NuttyShell/NuttyBadge/README.md

# NuttyBadge
NuttyBadge: A NuttyShell crafted security and hardware multi-tool. Open-sourced Hardware and Software.

## Hardware
[Click here for Hardware](NuttyHardware): Full Schematic and PCBs, along with BOM list

## Software
[Click here for Software](NuttyOS): Full Software based on ESP-IDF and FreeRTOS
