NuttyShell/NuttyBadge/NuttyHardware/Drill.png

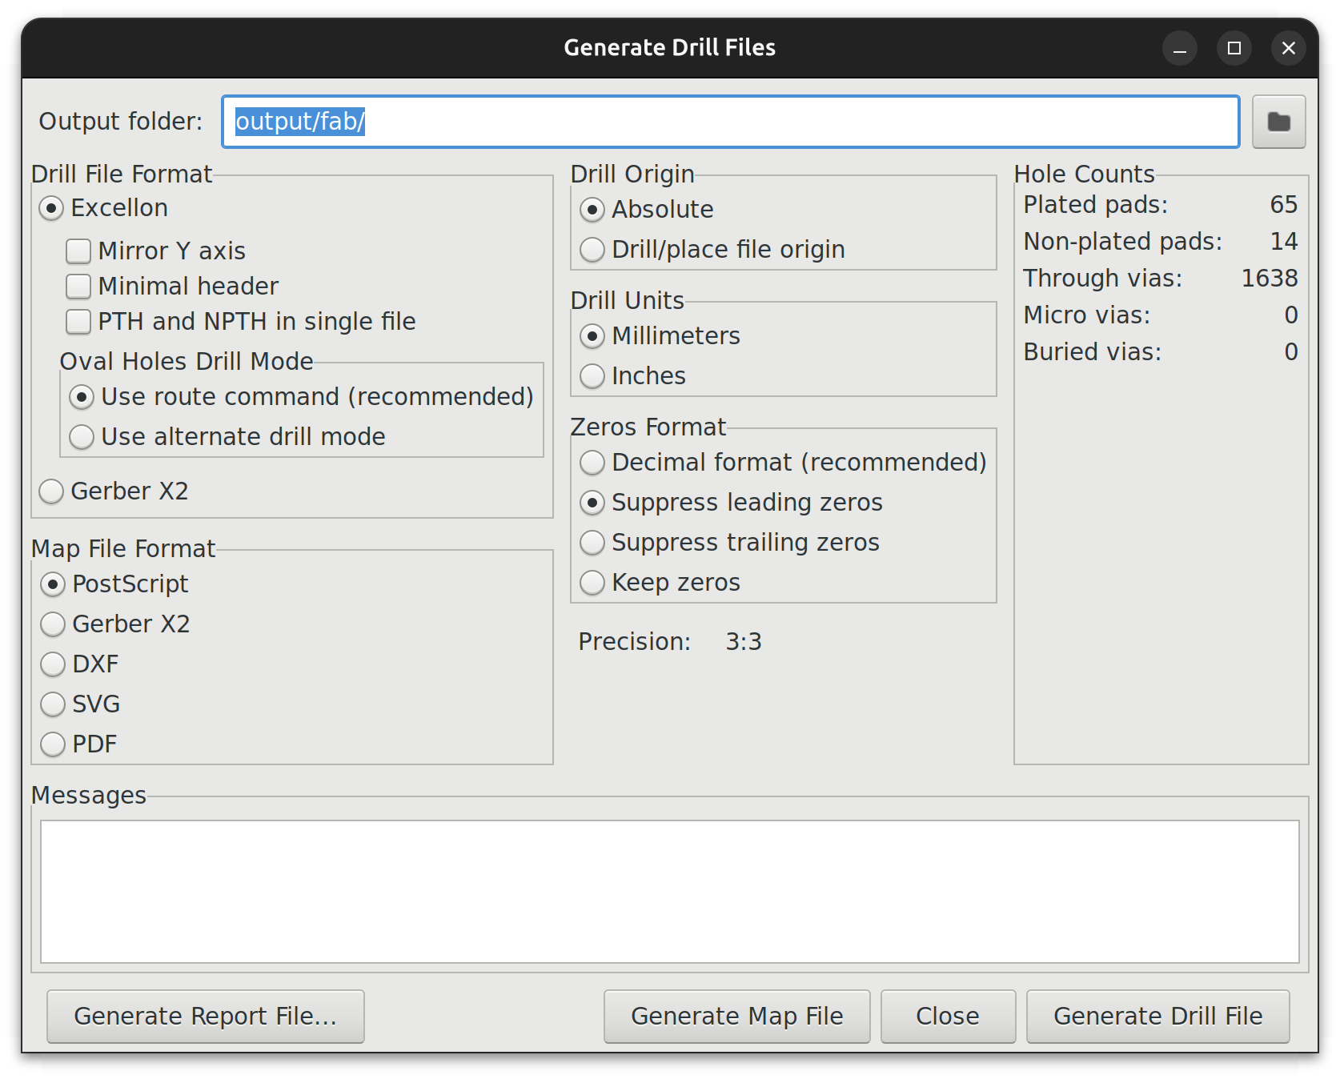
NuttyHardware/Drill.png
