NuttyShell/NuttyBadge/NuttyHardware/Gerber.png

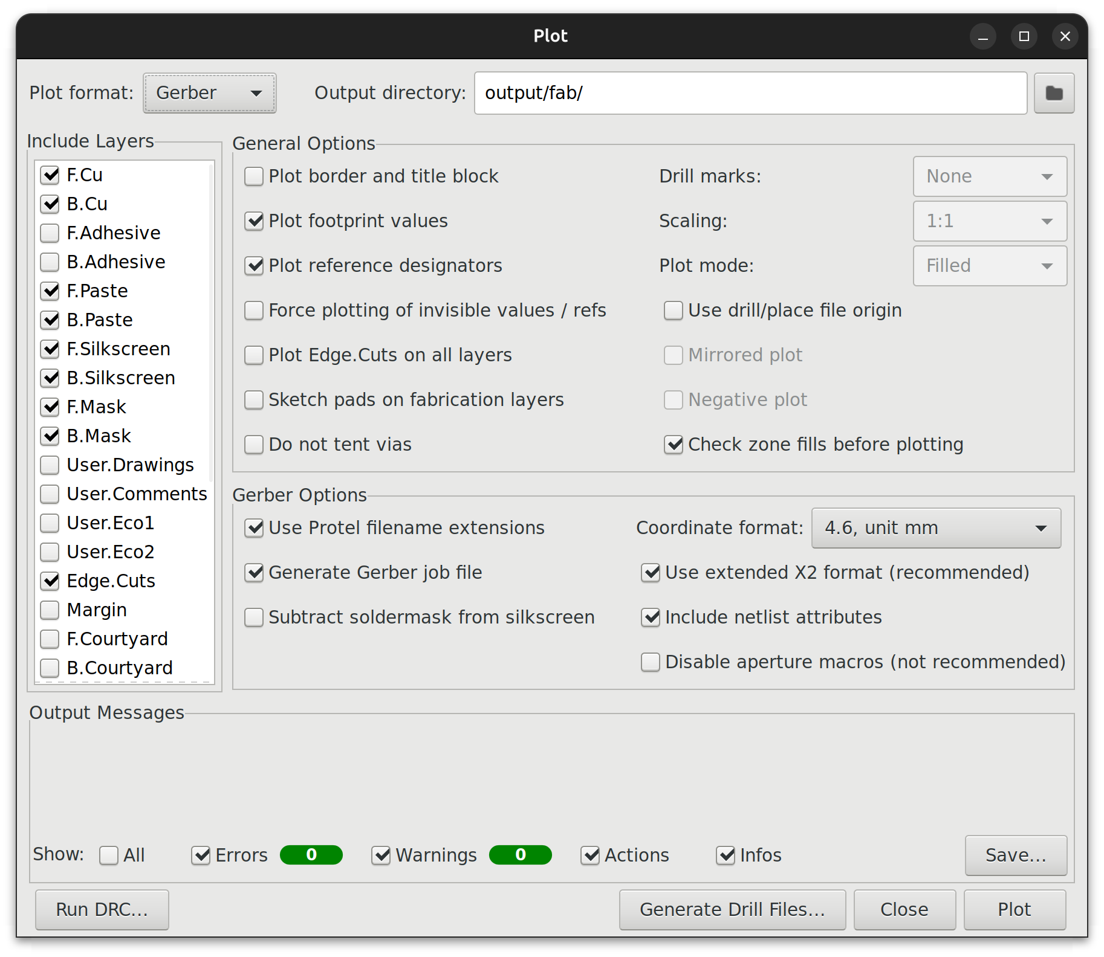
NuttyHardware/Gerber.png
