NuttyShell/NuttyBadge/NuttyHardware/vendor_modules/esp32-s3-luatos/esp32s3.F.png

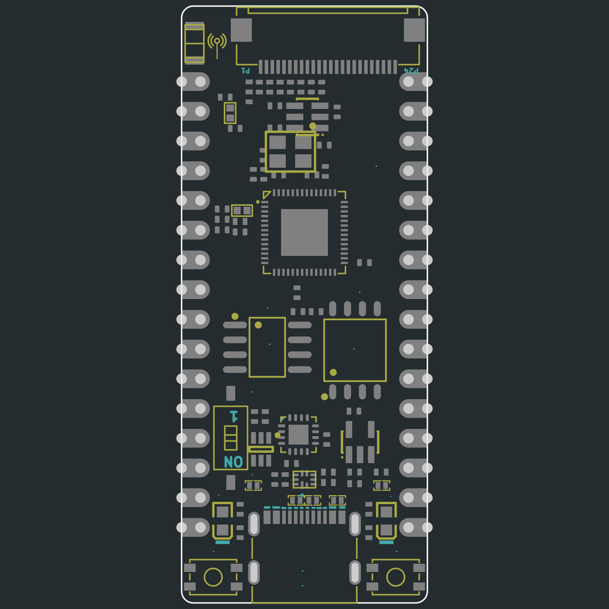
NuttyHardware/vendor_modules/esp32-s3-luatos/esp32s3.F.png
