NuttyShell/NuttyBadge/NuttyHardware/ViaStitching-KiCAD7-Settings.png

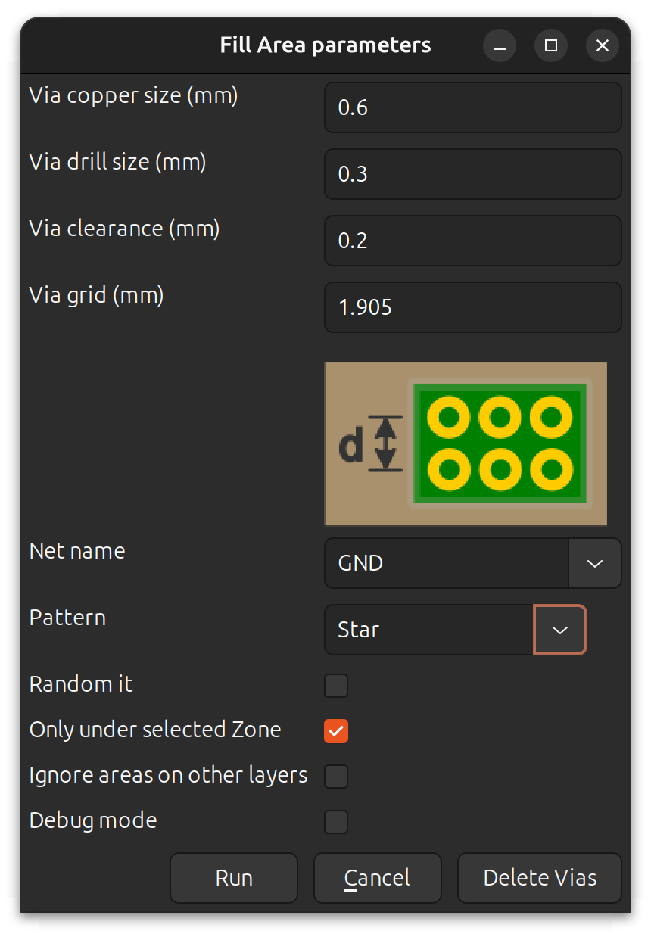
NuttyHardware/ViaStitching-KiCAD7-Settings.png
