NuttyShell/NuttyBadge/NuttyHardware/mass_production_revc/BOM_PCBA.xlsx

Reference(s) | 值 | LibPart | Footprint | 描述 | 封装 | 淘宝参考链接 | 类型
BT1 | AA_Battery | Device:Battery | Custom:BatteryHolder_2AA | 2节5号电池盒 | 直插电池盒 | https://item.taobao.com/item.htm?id=607322824447 | 直插
BZ1 | 8530_SMDPassiveBuzzer | Device:Buzzer | Buzzer_Beeper:MagneticBuzzer_Kobitone_254-EMB84Q-RO | MLT-8530 [3V] 电磁式贴片蜂鸣器 | 8530 | https://item.taobao.com/item.htm?id=555924156309 | 贴片
C1 | 100n | Device:C_Small | Capacitor_SMD:C_1206_3216Metric_Pad1.33x1.80mm_HandSolder | 104 ±10% 贴片电容 | 1206 | https://item.taobao.com/item.htm?id=635534146001 | 贴片
C2 | 100n | Device:C_Small | Capacitor_SMD:C_1206_3216Metric_Pad1.33x1.80mm_HandSolder | 104 ±10% 贴片电容 | 1206 | https://item.taobao.com/item.htm?id=635534146001 | 贴片
C3 | 100n | Device:C | Capacitor_SMD:C_1206_3216Metric_Pad1.33x1.80mm_HandSolder | 104 ±10% 贴片电容 | 1206 | https://item.taobao.com/item.htm?id=635534146001 | 贴片
C4 | 100n | Device:C | Capacitor_SMD:C_1206_3216Metric_Pad1.33x1.80mm_HandSolder | 104 ±10% 贴片电容 | 1206 | https://item.taobao.com/item.htm?id=635534146001 | 贴片
C5 | 100n | Device:C_Small | Capacitor_SMD:C_1206_3216Metric_Pad1.33x1.80mm_HandSolder | 104 ±10% 贴片电容 | 1206 | https://item.taobao.com/item.htm?id=635534146001 | 贴片
C6 | 100n | Device:C_Small | Capacitor_SMD:C_1206_3216Metric_Pad1.33x1.80mm_HandSolder | 104 ±10% 贴片电容 | 1206 | https://item.taobao.com/item.htm?id=635534146001 | 贴片
C7 | 100n | Device:C_Small | Capacitor_SMD:C_1206_3216Metric_Pad1.33x1.80mm_HandSolder | 104 ±10% 贴片电容 | 1206 | https://item.taobao.com/item.htm?id=635534146001 | 贴片
C8 | 10u | Device:C | Capacitor_SMD:C_1206_3216Metric_Pad1.33x1.80mm_HandSolder | 106 ±10% X5R 贴片电容 | 1206 | https://item.taobao.com/item.htm?id=537772527714 | 贴片
C9 | 100n | Device:C | Capacitor_SMD:C_1206_3216Metric_Pad1.33x1.80mm_HandSolder | 104 ±10% 贴片电容 | 1206 | https://item.taobao.com/item.htm?id=635534146001 | 贴片
C10 | 100n | Device:C | Capacitor_SMD:C_1206_3216Metric_Pad1.33x1.80mm_HandSolder | 104 ±10% 贴片电容 | 1206 | https://item.taobao.com/item.htm?id=635534146001 | 贴片
C11 | 100n | Device:C | Capacitor_SMD:C_1206_3216Metric_Pad1.33x1.80mm_HandSolder | 104 ±10% 贴片电容 | 1206 | https://item.taobao.com/item.htm?id=635534146001 | 贴片
C12 | 100n | Device:C | Capacitor_SMD:C_1206_3216Metric_Pad1.33x1.80mm_HandSolder | 104 ±10% 贴片电容 | 1206 | https://item.taobao.com/item.htm?id=635534146001 | 贴片
C13 | 10u | Device:C | Capacitor_SMD:C_1206_3216Metric_Pad1.33x1.80mm_HandSolder | 106 ±10% X5R 贴片电容 | 1206 | https://item.taobao.com/item.htm?id=537772527714 | 贴片
C14 | 100n | Device:C | Capacitor_SMD:C_1206_3216Metric_Pad1.33x1.80mm_HandSolder | 104 ±10% 贴片电容 | 1206 | https://item.taobao.com/item.htm?id=635534146001 | 贴片
C15 | 100n | Device:C_Small | Capacitor_SMD:C_1206_3216Metric_Pad1.33x1.80mm_HandSolder | 104 ±10% 贴片电容 | 1206 | https://item.taobao.com/item.htm?id=635534146001 | 贴片
C16 | 10u | Device:C_Small | Capacitor_SMD:C_1206_3216Metric_Pad1.33x1.80mm_HandSolder | 106 ±10% X5R 贴片电容 | 1206 | https://item.taobao.com/item.htm?id=537772527714 | 贴片
C17 | 100n | Device:C | Capacitor_SMD:C_1206_3216Metric_Pad1.33x1.80mm_HandSolder | 104 ±10% 贴片电容 | 1206 | https://item.taobao.com/item.htm?id=635534146001 | 贴片
C18 | 10u | Device:C_Small | Capacitor_SMD:C_1206_3216Metric_Pad1.33x1.80mm_HandSolder | 106 ±10% X5R 贴片电容 | 1206 | https://item.taobao.com/item.htm?id=537772527714 | 贴片
C19 | 100n | Device:C_Small | Capacitor_SMD:C_1206_3216Metric_Pad1.33x1.80mm_HandSolder | 104 ±10% 贴片电容 | 1206 | https://item.taobao.com/item.htm?id=635534146001 | 贴片
C20 | 1u | Device:C_Small | Capacitor_SMD:C_1206_3216Metric_Pad1.33x1.80mm_HandSolder | 105 ±10% X7R 贴片电容 | 1206 | https://item.taobao.com/item.htm?id=561250887432 | 贴片
C21 | 100n | Device:C_Small | Capacitor_SMD:C_1206_3216Metric_Pad1.33x1.80mm_HandSolder | 104 ±10% 贴片电容 | 1206 | https://item.taobao.com/item.htm?id=635534146001 | 贴片
C22 | 10u | Device:C | Capacitor_SMD:C_1206_3216Metric_Pad1.33x1.80mm_HandSolder | 106 ±10% X5R 贴片电容 | 1206 | https://item.taobao.com/item.htm?id=537772527714 | 贴片
C23 | 1u | Device:C_Small | Capacitor_SMD:C_1206_3216Metric_Pad1.33x1.80mm_HandSolder | 105 ±10% X7R 贴片电容 | 1206 | https://item.taobao.com/item.htm?id=561250887432 | 贴片
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
C50 | 100n | Device:C | Capacitor_SMD:C_1206_3216Metric_Pad1.33x1.80mm_HandSolder | 104 ±10% 贴片电容 | 1206 | https://item.taobao.com/item.htm?id=635534146001 | 贴片
C51 | NC | Device:C | Capacitor_SMD:C_1206_3216Metric_Pad1.33x1.80mm_HandSolder | 不用焊接 | 不用焊接 | 不用焊接 | 不用焊接
C52 | 10u | Device:C | Capacitor_SMD:C_1206_3216Metric_Pad1.33x1.80mm_HandSolder | 106 ±10% X5R 贴片电容 | 1206 | https://item.taobao.com/item.htm?id=537772527714 | 贴片
D1 | 1N4148W | Diode:1N4148W | Custom:D_SOD-123-BigDiodeSilkscreen | 贴片开关二极管 | SOD-123 | https://item.taobao.com/item.htm?id=660511928550 | 贴片
D2 | 1N4148W | Diode:1N4148W | Custom:D_SOD-123-BigDiodeSilkscreen | 贴片开关二极管 | SOD-123 | https://item.taobao.com/item.htm?id=660511928550 | 贴片
D3 | 1N4148W | Diode:1N4148W | Custom:D_SOD-123-BigDiodeSilkscreen | 贴片开关二极管 | SOD-123 | https://item.taobao.com/item.htm?id=660511928550 | 贴片
D4 | 1N4148W | Diode:1N4148W | Custom:D_SOD-123-BigDiodeSilkscreen | 贴片开关二极管 | SOD-123 | https://item.taobao.com/item.htm?id=660511928550 | 贴片
D5 | 1N4148W | Diode:1N4148W | Custom:D_SOD-123-BigDiodeSilkscreen | 贴片开关二极管 | SOD-123 | https://item.taobao.com/item.htm?id=660511928550 | 贴片
D6 | 1N4148W | Diode:1N4148W | Custom:D_SOD-123-BigDiodeSilkscreen | 贴片开关二极管 | SOD-123 | https://item.taobao.com/item.htm?id=660511928550 | 贴片
D7 | 1N4148W | Diode:1N4148W | Custom:D_SOD-123-BigDiodeSilkscreen | 贴片开关二极管 | SOD-123 | https://item.taobao.com/item.htm?id=660511928550 | 贴片
D8 | 1N4148W | Diode:1N4148W | Custom:D_SOD-123-BigDiodeSilkscreen | 贴片开关二极管 | SOD-123 | https://item.taobao.com/item.htm?id=660511928550 | 贴片
D9 | 1N4148W | Diode:1N4148W | Custom:D_SOD-123-BigDiodeSilkscreen | 贴片开关二极管 | SOD-123 | https://item.taobao.com/item.htm?id=660511928550 | 贴片
D10 | WS2812B | LED:WS2812B | Custom:LED_WS2812B_PLCC4_5.0x5.0mm_P3.2mm-TriangleSilkscreen | RGB发光二极管 | 5050 | https://item.taobao.com/item.htm?id=686018450822 | 贴片
D11 | WS2812B | LED:WS2812B | Custom:LED_WS2812B_PLCC4_5.0x5.0mm_P3.2mm-TriangleSilkscreen | RGB发光二极管 | 5050 | https://item.taobao.com/item.htm?id=686018450822 | 贴片
D12 | PMEG2005EGW | Diode:1N4148W | Custom:D_SOD-123-BigDiodeSilkscreen | 低VF MEGA肖特基势垒整流器 | SOD-123 | https://item.taobao.com/item.htm?id=586340327081 | 贴片
D13 | 940nmIR_5mmLED | Device:LED | LED_THT:LED_D5.0mm_Horizontal_O3.81mm_Z3.0mm | 940nm红外发射二极管 | 5mm 直插 | https://item.taobao.com/item.htm?id=522572650100 | 直插
D14 | 940nmIR_5mmLED | Device:LED | LED_THT:LED_D5.0mm_Horizontal_O3.81mm_Z3.0mm | 940nm红外发射二极管 | 5mm 直插 | https://item.taobao.com/item.htm?id=522572650100 | 直插
D15 | WS2812B | LED:WS2812B | Custom:LED_WS2812B_PLCC4_5.0x5.0mm_P3.2mm-TriangleSilkscreen | RGB发光二极管 | 5050 | https://item.taobao.com/item.htm?id=686018450822 | 贴片
D16 | 1N4148W | Diode:1N4148W | Custom:D_SOD-123-BigDiodeSilkscreen | 贴片开关二极管 | SOD-123 | https://item.taobao.com/item.htm?id=660511928550 | 贴片
D17 | PMEG2005EGW | Diode:1N4148W | Custom:D_SOD-123-BigDiodeSilkscreen | 低VF MEGA肖特基势垒整流器 | SOD-123 | https://item.taobao.com/item.htm?id=586340327081 | 贴片
D18 | SS34 | Diode:1N5822 | Custom:D_SMA_Handsoldering-BigDiodeSilkscreen | 肖特基二极管 | SMA (DO-214AC) | https://item.taobao.com/item.htm?id=545422120963 | 贴片
D19 | BLUE LED | Device:LED_Filled | Custom:LED_0805_2012Metric_Pad1.15x1.40mm_HandSolder-BigDiodeSilkscreen | 蓝色LED灯珠/发光二极管 | 0805 | https://item.taobao.com/item.htm?id=570459797098 | 贴片
FB1 | CBW321609U121T | Device:FerriteBead_Small | Inductor_SMD:L_1206_3216Metric_Pad1.42x1.75mm_HandSolder | 3A, 120R@100MHz, Rdc<0.1R 贴片磁珠 | 1206 | https://item.taobao.com/item.htm?id=655861159778 | 贴片
H1 | MountingHole | Mechanical:MountingHole | MountingHole:MountingHole_3.2mm_M3_ISO7380 | 固定孔，请忽略 | 固定孔，请忽略 | 固定孔，请忽略 | 固定孔，请忽略
H2 | MountingHole | Mechanical:MountingHole | MountingHole:MountingHole_3.2mm_M3_ISO7380 | 固定孔，请忽略 | 固定孔，请忽略 | 固定孔，请忽略 | 固定孔，请忽略
H3 | MountingHole | Mechanical:MountingHole | MountingHole:MountingHole_3.2mm_M3_ISO7380 | 固定孔，请忽略 | 固定孔，请忽略 | 固定孔，请忽略 | 固定孔，请忽略
H4 | MountingHole | Mechanical:MountingHole | MountingHole:MountingHole_3.2mm_M3_ISO7380 | 固定孔，请忽略 | 固定孔，请忽略 | 固定孔，请忽略 | 固定孔，请忽略
J1 | RGB_OUT | Connector:Conn_01x03_Male | Connector_PinHeader_2.54mm:PinHeader_1x03_P2.54mm_Vertical | 不用焊接 | 不用焊接 | 不用焊接 | 不用焊接
J2 | CC_MODULE | Connector_Generic:Conn_02x04_Odd_Even | Custom:PinSocket_2x04_P2.54mm_Vertical_PinNumberFlipped | 不用焊接 | 不用焊接 | 不用焊接 | 不用焊接
J3 | Micro_SD_Card_Det | MicroSD_Slot:Micro_SD_Card_Det | Custom:Conn_uSDcard | 贴片TF卡卡座 外焊-自弹-镀金 | 见淘宝链接 | https://item.taobao.com/item.htm?id=720212395210 | 贴片
J4 | Expose_GPIOs | Connector:Conn_01x07_Female | Connector_PinHeader_2.54mm:PinHeader_1x07_P2.54mm_Vertical | 不用焊接 | 不用焊接 | 不用焊接 | 不用焊接
J5 | I2C_Pins | Connector:Conn_01x04_Female | Connector_PinSocket_2.54mm:PinSocket_1x04_P2.54mm_Vertical | 不用焊接 | 不用焊接 | 不用焊接 | 不用焊接
J6 | Power_Pins | Connector_Generic:Conn_02x04_Odd_Even | Custom:PinSocket_2x04_P2.54mm_Vertical_PinNumberFlipped | 不用焊接 | 不用焊接 | 不用焊接 | 不用焊接
J7 | Expose_SDPins | Connector:Conn_01x05_Female | Connector_PinHeader_2.54mm:PinHeader_1x05_P2.54mm_Vertical | 不用焊接 | 不用焊接 | 不用焊接 | 不用焊接
J8 | FPC0.5-24P | Connector_Generic:Conn_01x24 | Connector_FFC-FPC:Jushuo_AFC07-S24FCA-00_1x24-1MP_P0.50_Horizontal | 24P 0.5mm FPC 翻盖 下接 连接器 | FPC 0.5mm | https://item.taobao.com/item.htm?id=552629356951 | 贴片
J9 | USB Type-C Port | Connector:USB_C_Receptacle_USB2.0 | Connector_USB:USB_C_Receptacle_HRO_TYPE-C-31-M-12 | USB Type-C 16P母座(板上四脚插)-蓝色 | 蓝色 Type-C USB 母座 | https://item.taobao.com/item.htm?id=737614485085 | 贴片
L1 | 3.3uH | Device:L | Inductor_SMD:L_Wuerth_HCI-1040 | 3.3uH 贴片功率电感 | 1040 | https://item.taobao.com/item.htm?id=624687278924 | 贴片
Q1 | MMBT3904 | Transistor_BJT:MMBT3904 | Q1 | NPN晶体管 | SOT-23 | https://item.taobao.com/item.htm?id=578927102886 | 贴片
Q2 | NC | Transistor_FET:AO3400A | Q2 | 不用焊接 | 不用焊接 | 不用焊接 | 不用焊接
Q3 | IRF9321PbF | Transistor_FET:IRF7404 | Q3 | P沟道 MOSFET管 | SOIC-8 | https://item.taobao.com/item.htm?id=582370943063 | 贴片
Q4 | AO3400A | Transistor_FET:AO3400A | Q4 | N沟道 MOSFET管 | SOT-23 | https://item.taobao.com/item.htm?id=619513547316 | 贴片
Q5 | MMBT3904 | Transistor_BJT:MMBT3904 | Q5 | NPN晶体管 | SOT-23 | https://item.taobao.com/item.htm?id=578927102886 | 贴片
Q6 | MMBT3904 | Transistor_BJT:MMBT3904 | Q6 | NPN晶体管 | SOT-23 | https://item.taobao.com/item.htm?id=578927102886 | 贴片
Q7 | MMBT3904 | Transistor_BJT:MMBT3904 | Q7 | NPN晶体管 | SOT-23 | https://item.taobao.com/item.htm?id=578927102886 | 贴片
Q8 | MMBT3904 | Transistor_BJT:MMBT3904 | Q8 | NPN晶体管 | SOT-23 | https://item.taobao.com/item.htm?id=578927102886 | 贴片
Q9 | FDC6333C | Transistor_FET:DMC2053UVT | Q9 | N+P沟道 MOSFET管 | SOT-23-6 | https://item.taobao.com/item.htm?id=678270445729 | 贴片
Q10 | AO3401A | Transistor_FET:AO3401A | Q10 | P沟道 MOSFET管 | SOT-23 | https://item.taobao.com/item.htm?id=619514059506 | 贴片
Q11 | AO3400A | Transistor_FET:AO3400A | Q11 | N沟道 MOSFET管 | SOT-23 | https://item.taobao.com/item.htm?id=619513547316 | 贴片
Q12 | AO3401A | Transistor_FET:AO3401A | Q12 | P沟道 MOSFET管 | SOT-23 | https://item.taobao.com/item.htm?id=619514059506 | 贴片
R1 | 10K | Device:R | Resistor_SMD:R_1206_3216Metric_Pad1.30x1.75mm_HandSolder | 1002 贴片电阻 精度±1% | 1206 | https://item.taobao.com/item.htm?id=526184346746 | 贴片
R2 | 10K | Device:R | Resistor_SMD:R_1206_3216Metric_Pad1.30x1.75mm_HandSolder | 1002 贴片电阻 精度±1% | 1206 | https://item.taobao.com/item.htm?id=526184346746 | 贴片
R3 | 10K | Device:R | Resistor_SMD:R_1206_3216Metric_Pad1.30x1.75mm_HandSolder | 1002 贴片电阻 精度±1% | 1206 | https://item.taobao.com/item.htm?id=526184346746 | 贴片
R4 | 10K | Device:R | Resistor_SMD:R_1206_3216Metric_Pad1.30x1.75mm_HandSolder | 1002 贴片电阻 精度±1% | 1206 | https://item.taobao.com/item.htm?id=526184346746 | 贴片
R5 | 10K | Device:R | Resistor_SMD:R_1206_3216Metric_Pad1.30x1.75mm_HandSolder | 1002 贴片电阻 精度±1% | 1206 | https://item.taobao.com/item.htm?id=526184346746 | 贴片
R6 | 2K2 | Device:R | Resistor_SMD:R_1206_3216Metric_Pad1.30x1.75mm_HandSolder | 2201 贴片电阻 精度±1% | 1206 | https://item.taobao.com/item.htm?id=526184346746 | 贴片
R7 | 10K | Device:R | Resistor_SMD:R_1206_3216Metric_Pad1.30x1.75mm_HandSolder | 1002 贴片电阻 精度±1% | 1206 | https://item.taobao.com/item.htm?id=526184346746 | 贴片
R8 | 2K2 | Device:R | Resistor_SMD:R_1206_3216Metric_Pad1.30x1.75mm_HandSolder | 2201 贴片电阻 精度±1% | 1206 | https://item.taobao.com/item.htm?id=526184346746 | 贴片
R9 | 10R | Device:R | Resistor_SMD:R_1206_3216Metric_Pad1.30x1.75mm_HandSolder | 10R0 贴片电阻 精度±1% | 1206 | https://item.taobao.com/item.htm?id=526170748623 | 贴片
R10 | 10K | Device:R | Resistor_SMD:R_1206_3216Metric_Pad1.30x1.75mm_HandSolder | 1002 贴片电阻 精度±1% | 1206 | https://item.taobao.com/item.htm?id=526184346746 | 贴片
R11 | NC | Device:R | Resistor_SMD:R_1206_3216Metric_Pad1.30x1.75mm_HandSolder | 不用焊接 | 不用焊接 | 不用焊接 | 不用焊接
R12 | 3K | Device:R | Resistor_SMD:R_1206_3216Metric_Pad1.30x1.75mm_HandSolder | 3001 贴片电阻 精度±1% | 1206 | https://item.taobao.com/item.htm?id=526175737633 | 贴片
R13 | 1K | Device:R | Resistor_SMD:R_1206_3216Metric_Pad1.30x1.75mm_HandSolder | 1001 贴片电阻 精度±1% | 1206 | https://item.taobao.com/item.htm?id=526176009170 | 贴片
R14 | 10K | Device:R | Resistor_SMD:R_1206_3216Metric_Pad1.30x1.75mm_HandSolder | 1002 贴片电阻 精度±1% | 1206 | https://item.taobao.com/item.htm?id=526184346746 | 贴片
R15 | 10K | Device:R | Resistor_SMD:R_1206_3216Metric_Pad1.30x1.75mm_HandSolder | 1002 贴片电阻 精度±1% | 1206 | https://item.taobao.com/item.htm?id=526184346746 | 贴片
R16 | 10K | Device:R | Resistor_SMD:R_1206_3216Metric_Pad1.30x1.75mm_HandSolder | 1002 贴片电阻 精度±1% | 1206 | https://item.taobao.com/item.htm?id=526184346746 | 贴片
R17 | 10K | Device:R | Resistor_SMD:R_1206_3216Metric_Pad1.30x1.75mm_HandSolder | 1002 贴片电阻 精度±1% | 1206 | https://item.taobao.com/item.htm?id=526184346746 | 贴片
R18 | NC | Device:R | Resistor_SMD:R_1206_3216Metric_Pad1.30x1.75mm_HandSolder | 不用焊接 | 不用焊接 | 不用焊接 | 不用焊接
R19 | 10K | Device:R | Resistor_SMD:R_1206_3216Metric_Pad1.30x1.75mm_HandSolder | 1002 贴片电阻 精度±1% | 1206 | https://item.taobao.com/item.htm?id=526184346746 | 贴片
R20 | 10K | Device:R | Resistor_SMD:R_1206_3216Metric_Pad1.30x1.75mm_HandSolder | 1002 贴片电阻 精度±1% | 1206 | https://item.taobao.com/item.htm?id=526184346746 | 贴片
R21 | 10K | Device:R | Resistor_SMD:R_1206_3216Metric_Pad1.30x1.75mm_HandSolder | 1002 贴片电阻 精度±1% | 1206 | https://item.taobao.com/item.htm?id=526184346746 | 贴片
R22 | 47K | Device:R | Resistor_SMD:R_1206_3216Metric_Pad1.30x1.75mm_HandSolder | 4702 贴片电阻 精度±1% | 1206 | https://item.taobao.com/item.htm?id=526184346746 | 贴片
R23 | 1K | Device:R | Resistor_SMD:R_1206_3216Metric_Pad1.30x1.75mm_HandSolder | 1001 贴片电阻 精度±1% | 1206 | https://item.taobao.com/item.htm?id=526176009170 | 贴片
R24 | 100 | Device:R | Resistor_SMD:R_1206_3216Metric_Pad1.30x1.75mm_HandSolder | 1000 贴片电阻 精度±1% | 1206 | https://item.taobao.com/item.htm?id=526184346746 | 贴片
R25 | 10K | Device:R | Resistor_SMD:R_1206_3216Metric_Pad1.30x1.75mm_HandSolder | 1002 贴片电阻 精度±1% | 1206 | https://item.taobao.com/item.htm?id=526184346746 | 贴片
R26 | 2K2 | Device:R | Resistor_SMD:R_1206_3216Metric_Pad1.30x1.75mm_HandSolder | 2201 贴片电阻 精度±1% | 1206 | https://item.taobao.com/item.htm?id=526184346746 | 贴片
R27 | 10K | Device:R | Resistor_SMD:R_1206_3216Metric_Pad1.30x1.75mm_HandSolder | 1002 贴片电阻 精度±1% | 1206 | https://item.taobao.com/item.htm?id=526184346746 | 贴片
R28 | 10K | Device:R | Resistor_SMD:R_1206_3216Metric_Pad1.30x1.75mm_HandSolder | 1002 贴片电阻 精度±1% | 1206 | https://item.taobao.com/item.htm?id=526184346746 | 贴片
R29 | 10K | Device:R | Resistor_SMD:R_1206_3216Metric_Pad1.30x1.75mm_HandSolder | 1002 贴片电阻 精度±1% | 1206 | https://item.taobao.com/item.htm?id=526184346746 | 贴片
R30 | 3K | Device:R | Resistor_SMD:R_1206_3216Metric_Pad1.30x1.75mm_HandSolder | 3001 贴片电阻 精度±1% | 1206 | https://item.taobao.com/item.htm?id=526175737633 | 贴片
R31 | 10K | Device:R | Resistor_SMD:R_1206_3216Metric_Pad1.30x1.75mm_HandSolder | 1002 贴片电阻 精度±1% | 1206 | https://item.taobao.com/item.htm?id=526184346746 | 贴片
R32 | 10K | Device:R | Resistor_SMD:R_1206_3216Metric_Pad1.30x1.75mm_HandSolder | 1002 贴片电阻 精度±1% | 1206 | https://item.taobao.com/item.htm?id=526184346746 | 贴片
R33 | 10K | Device:R | Resistor_SMD:R_1206_3216Metric_Pad1.30x1.75mm_HandSolder | 1002 贴片电阻 精度±1% | 1206 | https://item.taobao.com/item.htm?id=526184346746 | 贴片
R34 | 12K | Device:R | Resistor_SMD:R_1206_3216Metric_Pad1.30x1.75mm_HandSolder | 1202 贴片电阻 精度±1% | 1206 | https://item.taobao.com/item.htm?id=526184346746 | 贴片
R35 | 12K | Device:R | Resistor_SMD:R_1206_3216Metric_Pad1.30x1.75mm_HandSolder | 1202 贴片电阻 精度±1% | 1206 | https://item.taobao.com/item.htm?id=526184346746 | 贴片
R36 | 5.1K | Device:R | Resistor_SMD:R_1206_3216Metric_Pad1.30x1.75mm_HandSolder | 5101 贴片电阻 精度±1% | 1206 | https://item.taobao.com/item.htm?id=526184346746 | 贴片
R37 | 100 | Device:R | Resistor_SMD:R_1206_3216Metric_Pad1.30x1.75mm_HandSolder | 1000 贴片电阻 精度±1% | 1206 | https://item.taobao.com/item.htm?id=526184346746 | 贴片
R38 | 5.1K | Device:R | Resistor_SMD:R_1206_3216Metric_Pad1.30x1.75mm_HandSolder | 5101 贴片电阻 精度±1% | 1206 | https://item.taobao.com/item.htm?id=526184346746 | 贴片
R39 | 100K | Device:R | Resistor_SMD:R_1206_3216Metric_Pad1.30x1.75mm_HandSolder | 1003 贴片电阻 精度±0.1% | 1206 | https://item.taobao.com/item.htm?id=632324942821 | 贴片
R40 | 100K | Device:R | Resistor_SMD:R_1206_3216Metric_Pad1.30x1.75mm_HandSolder | 1003 贴片电阻 精度±0.1% | 1206 | https://item.taobao.com/item.htm?id=632324942821 | 贴片
R41 | 100 | Device:R | Resistor_SMD:R_1206_3216Metric_Pad1.30x1.75mm_HandSolder | 1000 贴片电阻 精度±1% | 1206 | https://item.taobao.com/item.htm?id=526184346746 | 贴片
R42 | 100K | Device:R | Resistor_SMD:R_1206_3216Metric_Pad1.30x1.75mm_HandSolder | 1003 贴片电阻 精度±0.1% | 1206 | https://item.taobao.com/item.htm?id=632324942821 | 贴片
R43 | 1K | Device:R | Resistor_SMD:R_1206_3216Metric_Pad1.30x1.75mm_HandSolder | 1001 贴片电阻 精度±1% | 1206 | https://item.taobao.com/item.htm?id=526176009170 | 贴片
R44 | 100K | Device:R | Resistor_SMD:R_1206_3216Metric_Pad1.30x1.75mm_HandSolder | 1003 贴片电阻 精度±0.1% | 1206 | https://item.taobao.com/item.htm?id=632324942821 | 贴片
R45 | 1K | Device:R | Resistor_SMD:R_1206_3216Metric_Pad1.30x1.75mm_HandSolder | 1001 贴片电阻 精度±1% | 1206 | https://item.taobao.com/item.htm?id=526176009170 | 贴片
SW1 | BTN_UP | Switch:SW_Push | Custom:SW_Push_1P1T_NO_CK_PTS125Sx43PSMTR_NoHoles | 贴片轻触开关 | 12*12*7.3 | https://item.taobao.com/item.htm?id=610328371652 | 贴片
SW2 | BTN_RIGHT | Switch:SW_Push | Custom:SW_Push_1P1T_NO_CK_PTS125Sx43PSMTR_NoHoles | 贴片轻触开关 | 12*12*7.3 | https://item.taobao.com/item.htm?id=610328371652 | 贴片
SW3 | BTN_SELECT | Switch:SW_Push | Custom:SW_Push_1P1T_NO_CK_PTS125Sx43PSMTR_NoHoles | 贴片轻触开关 | 12*12*7.3 | https://item.taobao.com/item.htm?id=610328371652 | 贴片
SW4 | BTN_DOWN | Switch:SW_Push | Custom:SW_Push_1P1T_NO_CK_PTS125Sx43PSMTR_NoHoles | 贴片轻触开关 | 12*12*7.3 | https://item.taobao.com/item.htm?id=610328371652 | 贴片
SW5 | BTN_A | Switch:SW_Push | Custom:SW_Push_1P1T_NO_CK_PTS125Sx43PSMTR_NoHoles | 贴片轻触开关 | 12*12*7.3 | https://item.taobao.com/item.htm?id=610328371652 | 贴片
SW6 | BTN_START | Switch:SW_Push | Custom:SW_Push_1P1T_NO_CK_PTS125Sx43PSMTR_NoHoles | 贴片轻触开关 | 12*12*7.3 | https://item.taobao.com/item.htm?id=610328371652 | 贴片
SW7 | BTN_LEFT | Switch:SW_Push | Custom:SW_Push_1P1T_NO_CK_PTS125Sx43PSMTR_NoHoles | 贴片轻触开关 | 12*12*7.3 | https://item.taobao.com/item.htm?id=610328371652 | 贴片
SW8 | BTN_B | Switch:SW_Push | Custom:SW_Push_1P1T_NO_CK_PTS125Sx43PSMTR_NoHoles | 贴片轻触开关 | 12*12*7.3 | https://item.taobao.com/item.htm?id=610328371652 | 贴片
SW9 | BTN_USRDEF | Switch:SW_Push | Custom:SW_Push_1P1T_NO_CK_PTS125Sx43PSMTR_NoHoles | 贴片轻触开关 | 12*12*7.3 | https://item.taobao.com/item.htm?id=610328371652 | 贴片
SW10 | SW_DPDT_x2 | Switch:SW_DPDT_x2 | Custom:SW_DPDT_Power_Switch | 贴片拨动开关 6脚2档 MSK-1141-6P-2H | 见淘宝链接 | https://item.taobao.com/item.htm?id=718996552661 | 贴片
SW11 | BTN_RST | Switch:SW_Push | Button_Switch_SMD:SW_Push_1P1T_NO_Vertical_Wuerth_434133025816 | 贴片 包脚 4脚 微动开关 | 3*4*2.5 | https://item.taobao.com/item.htm?id=572616815375 | 贴片
SW12 | BTN_IO0 | Switch:SW_Push | Button_Switch_SMD:SW_Push_1P1T_NO_Vertical_Wuerth_434133025816 | 贴片 包脚 4脚 微动开关 | 3*4*2.5 | https://item.taobao.com/item.htm?id=572616815375 | 贴片
U1 | PCF8574T | Interface_Expansion:PCF8574A | U1 | I2C 8位I/O扩展器 | SOIC-16 | https://item.taobao.com/item.htm?id=547459821738 | 贴片
U2 | ESP32-S3-WROOM-1-N16R8 | ESP32S3_Module:ESP32-S3-WROOM-1-N16R8 | U2 | ESP32-S3-WROOM-1-N16R8 | 见淘宝链接 | https://detail.tmall.com/item.htm?id=899564417167 | 贴片
U3 | AMS1117-3.3 | Regulator_Linear:AMS1117-3.3 | U3 | AMS1117-3.3 降压IC | SOT-223 | https://item.taobao.com/item.htm?id=522579028878 | 贴片
U4 | IRM-3638T | Interface_Optical:TSOP38G36 | U4 | 红外接收头 | 见淘宝链接 | https://item.taobao.com/item.htm?id=522575401769 | 直插
U5 | M242-12864-7_SPIOLED | LCD_Module:GM12864T-5D_SPILCD | U5 | 12864 2.42寸 OLED显示模块 黄光 | 见淘宝链接 | https://item.taobao.com/item.htm?id=676710788988 | 半直插（灌锡）
U6 | TPS63001DRCR | Regulator_Switching:TPS63001 | U6 | 降压/升压转换器 | VSON-10 | https://item.taobao.com/item.htm?id=750142654431 | 贴片
U7 | ME6211A12M3G-N | LDO_Regulators:ME6211A12M3G-N | U7 | 1.2V LDO线性稳压器 | SOT-23 | https://item.taobao.com/item.htm?id=823215456032 | 贴片
U8 | ME6211A28M3G-N | LDO_Regulators:ME6211A28M3G-N | U8 | 2.8V LDO线性稳压器 | SOT-23 | https://item.taobao.com/item.htm?id=823160342041 | 贴片
U9 | AMS1117-3.3 | Regulator_Linear:AMS1117-3.3 | U9 | AMS1117-3.3 降压IC | SOT-223 | https://item.taobao.com/item.htm?id=522579028878 | 贴片
U10 | CH334R | WCH_Peripheral:CH334R | U10 | USB HUB控制器 | QSOP-16 | https://item.taobao.com/item.htm?id=895629101875 | 贴片
U11 | CH343P | WCH_Peripheral:CH343P | U11 | USB转高速串口 | QFN-16 | https://item.taobao.com/item.htm?id=787216930183 | 贴片
Y1 | 12MHz | Device:Crystal_GND24_Small | Crystal:Crystal_SMD_3225-4Pin_3.2x2.5mm_HandSoldering | 12MHz 贴片无源晶振 ±10ppm 12pF | 3225 | https://item.taobao.com/item.htm?id=624959705517 | 贴片
