NuttyShell/NuttyBadge/NuttyHardware/mass_production_revc/BOM_PCBA_整合BOM.xlsx

Reference(s) | 数量 | 值 | 描述 | 封装 | 淘宝参考链接 | 类型
BT1 | 1 | AA_Battery | 2节5号电池盒 | 直插电池盒 | https://item.taobao.com/item.htm?id=607322824447 | 直插
BZ1 | 1 | 8530_SMDPassiveBuzzer | MLT-8530 [3V] 电磁式贴片蜂鸣器 | 8530 | https://item.taobao.com/item.htm?id=555924156309 | 贴片
C1, C2, C3, C4, C5, C6, C7, C9, C10, C11, C12, C14, C15, C17, C19, C21, C25, C26, C27, C28, C31, C33, C36, C37, C39, C44, C45, C46, C50 | 29 | 100n | 104 ±10% 贴片电容 | 1206 | https://item.taobao.com/item.htm?id=635534146001 | 贴片
C8, C13, C16, C18, C22, C34, C35, C38, C40, C43, C47, C52 | 12 | 10u | 106 ±10% X5R 贴片电容 | 1206 | https://item.taobao.com/item.htm?id=537772527714 | 贴片
C20, C23, C24, C41, C48 | 5 | 1u | 105 ±10% X7R 贴片电容 | 1206 | https://item.taobao.com/item.htm?id=561250887432 | 贴片
C42, C49, C51 | 3 | NC | 不用焊接 | 不用焊接 | 不用焊接 | 不用焊接
C29, C30, C32 | 3 | 47u | 476 ±20% 6.3V X5R 贴片电容 | 1206 | https://item.taobao.com/item.htm?id=522577016130 | 贴片
D1, D2, D3, D4, D5, D6, D7, D8, D9, D16 | 10 | 1N4148W | 贴片开关二极管 | SOD-123 | https://item.taobao.com/item.htm?id=660511928550 | 贴片
D10, D11, D15 | 3 | WS2812B | RGB发光二极管 | 5050 | https://item.taobao.com/item.htm?id=686018450822 | 贴片
D12, D17 | 2 | PMEG2005EGW | 低VF MEGA肖特基势垒整流器 | SOD-123 | https://item.taobao.com/item.htm?id=586340327081 | 贴片
D13, D14 | 2 | 940nmIR_5mmLED | 940nm红外发射二极管 | 5mm 直插 | https://item.taobao.com/item.htm?id=522572650100 | 直插
D18 | 1 | SS34 | 肖特基二极管 | SMA (DO-214AC) | https://item.taobao.com/item.htm?id=545422120963 | 贴片
D19 | 1 | BLUE LED | 蓝色LED灯珠/发光二极管 | 0805 | https://item.taobao.com/item.htm?id=570459797098 | 贴片
FB1 | 1 | CBW321609U121T | 3A, 120R@100MHz, Rdc<0.1R 贴片磁珠 | 1206 | https://item.taobao.com/item.htm?id=655861159778 | 贴片
H1, H2, H3, H4 | 4 | MountingHole | 固定孔，请忽略 | 固定孔，请忽略 | 固定孔，请忽略 | 固定孔，请忽略
J1 | 1 | RGB_OUT | 不用焊接 | 不用焊接 | 不用焊接 | 不用焊接
J2 | 1 | CC_MODULE | 不用焊接 | 不用焊接 | 不用焊接 | 不用焊接
J3 | 1 | Micro_SD_Card_Det | 贴片TF卡卡座 外焊-自弹-镀金 | 见淘宝链接 | https://item.taobao.com/item.htm?id=720212395210 | 贴片
J4 | 1 | Expose_GPIOs | 不用焊接 | 不用焊接 | 不用焊接 | 不用焊接
J5 | 1 | I2C_Pins | 不用焊接 | 不用焊接 | 不用焊接 | 不用焊接
J6 | 1 | Power_Pins | 不用焊接 | 不用焊接 | 不用焊接 | 不用焊接
J7 | 1 | Expose_SDPins | 不用焊接 | 不用焊接 | 不用焊接 | 不用焊接
J8 | 1 | FPC0.5-24P | 24P 0.5mm FPC 翻盖 下接 连接器 | FPC 0.5mm | https://item.taobao.com/item.htm?id=552629356951 | 贴片
J9 | 1 | USB Type-C Port | USB Type-C 16P母座(板上四脚插)-蓝色 | 蓝色 Type-C USB 母座 | https://item.taobao.com/item.htm?id=737614485085 | 贴片
L1 | 1 | 3.3uH | 3.3uH 贴片功率电感 | 1040 | https://item.taobao.com/item.htm?id=624687278924 | 贴片
Q1, Q5, Q6, Q7, Q8 | 5 | MMBT3904 | NPN晶体管 | SOT-23 | https://item.taobao.com/item.htm?id=578927102886 | 贴片
Q2 | 1 | NC | 不用焊接 | 不用焊接 | 不用焊接 | 不用焊接
Q4, Q11 | 2 | AO3400A | N沟道 MOSFET管 | SOT-23 | https://item.taobao.com/item.htm?id=619513547316 | 贴片
Q3 | 1 | IRF9321PbF | P沟道 MOSFET管 | SOIC-8 | https://item.taobao.com/item.htm?id=582370943063 | 贴片
Q9 | 1 | FDC6333C | N+P沟道 MOSFET管 | SOT-23-6 | https://item.taobao.com/item.htm?id=678270445729 | 贴片
Q10, Q12 | 2 | AO3401A | P沟道 MOSFET管 | SOT-23 | https://item.taobao.com/item.htm?id=619514059506 | 贴片
R1, R2, R3, R4, R5, R7, R10, R14, R15, R16, R17, R19, R20, R21, R25, R27, R28, R29, R31, R32, R33 | 21 | 10K | 1002 贴片电阻 精度±1% | 1206 | https://item.taobao.com/item.htm?id=526184346746 | 贴片
R6, R8, R26 | 3 | 2K2 | 2201 贴片电阻 精度±1% | 1206 | https://item.taobao.com/item.htm?id=526184346746 | 贴片
R9 | 1 | 10R | 10R0 贴片电阻 精度±1% | 1206 | https://item.taobao.com/item.htm?id=526170748623 | 贴片
R11, R18 | 2 | NC | 不用焊接 | 不用焊接 | 不用焊接 | 不用焊接
R24, R37, R41 | 3 | 100 | 1000 贴片电阻 精度±1% | 1206 | https://item.taobao.com/item.htm?id=526184346746 | 贴片
R12, R30 | 2 | 3K | 3001 贴片电阻 精度±1% | 1206 | https://item.taobao.com/item.htm?id=526175737633 | 贴片
R13, R23, R43, R45 | 4 | 1K | 1001 贴片电阻 精度±1% | 1206 | https://item.taobao.com/item.htm?id=526176009170 | 贴片
R22 | 1 | 47K | 4702 贴片电阻 精度±1% | 1206 | https://item.taobao.com/item.htm?id=526184346746 | 贴片
R34, R35 | 2 | 12K | 1202 贴片电阻 精度±1% | 1206 | https://item.taobao.com/item.htm?id=526184346746 | 贴片
R36, R38 | 2 | 5.1K | 5101 贴片电阻 精度±1% | 1206 | https://item.taobao.com/item.htm?id=526184346746 | 贴片
R39, R40, R42, R44 | 4 | 100K | 1003 贴片电阻 精度±0.1% | 1206 | https://item.taobao.com/item.htm?id=632324942821 | 贴片
SW1, SW2, SW3, SW4, SW5, SW6, SW7, SW8, SW9 | 9 | BTN_12*12*7.3 | 贴片轻触开关 | 12*12*7.3 | https://item.taobao.com/item.htm?id=610328371652 | 贴片
SW10 | 1 | SW_DPDT_x2 | 贴片拨动开关 6脚2档 MSK-1141-6P-2H | 见淘宝链接 | https://item.taobao.com/item.htm?id=718996552661 | 贴片
SW11, SW12 | 2 | BTN_3*4*2.5 | 贴片 包脚 4脚 微动开关 | 3*4*2.5 | https://item.taobao.com/item.htm?id=572616815375 | 贴片
U1 | 1 | PCF8574T | I2C 8位I/O扩展器 | SOIC-16 | https://item.taobao.com/item.htm?id=547459821738 | 贴片
U2 | 1 | ESP32-S3-WROOM-1-N16R8 | ESP32-S3-WROOM-1-N16R8 | 见淘宝链接 | https://detail.tmall.com/item.htm?id=899564417167 | 贴片
U3, U9 | 2 | AMS1117-3.3 | AMS1117-3.3 降压IC | SOT-223 | https://item.taobao.com/item.htm?id=522579028878 | 贴片
U4 | 1 | IRM-3638T | 红外接收头 | 见淘宝链接 | https://item.taobao.com/item.htm?id=522575401769 | 直插
U5 | 1 | M242-12864-7_SPIOLED | 12864 2.42寸 OLED显示模块 黄光 | 见淘宝链接 | https://item.taobao.com/item.htm?id=676710788988 | 半直插（灌锡）
U6 | 1 | TPS63001DRCR | 降压/升压转换器 | VSON-10 | https://item.taobao.com/item.htm?id=750142654431 | 贴片
U7 | 1 | ME6211A12M3G-N | 1.2V LDO线性稳压器 | SOT-23 | https://item.taobao.com/item.htm?id=823215456032 | 贴片
U8 | 1 | ME6211A28M3G-N | 2.8V LDO线性稳压器 | SOT-23 | https://item.taobao.com/item.htm?id=823160342041 | 贴片
U10 | 1 | CH334R | USB HUB控制器 | QSOP-16 | https://item.taobao.com/item.htm?id=895629101875 | 贴片
U11 | 1 | CH343P | USB转高速串口 | QFN-16 | https://item.taobao.com/item.htm?id=787216930183 | 贴片
Y1 | 1 | 12MHz | 12MHz 贴片无源晶振 ±10ppm 12pF | 3225 | https://item.taobao.com/item.htm?id=624959705517 | 贴片
