NuttyShell/NuttyBadge/NuttyHardware/mass_production_revc/badge.pdf

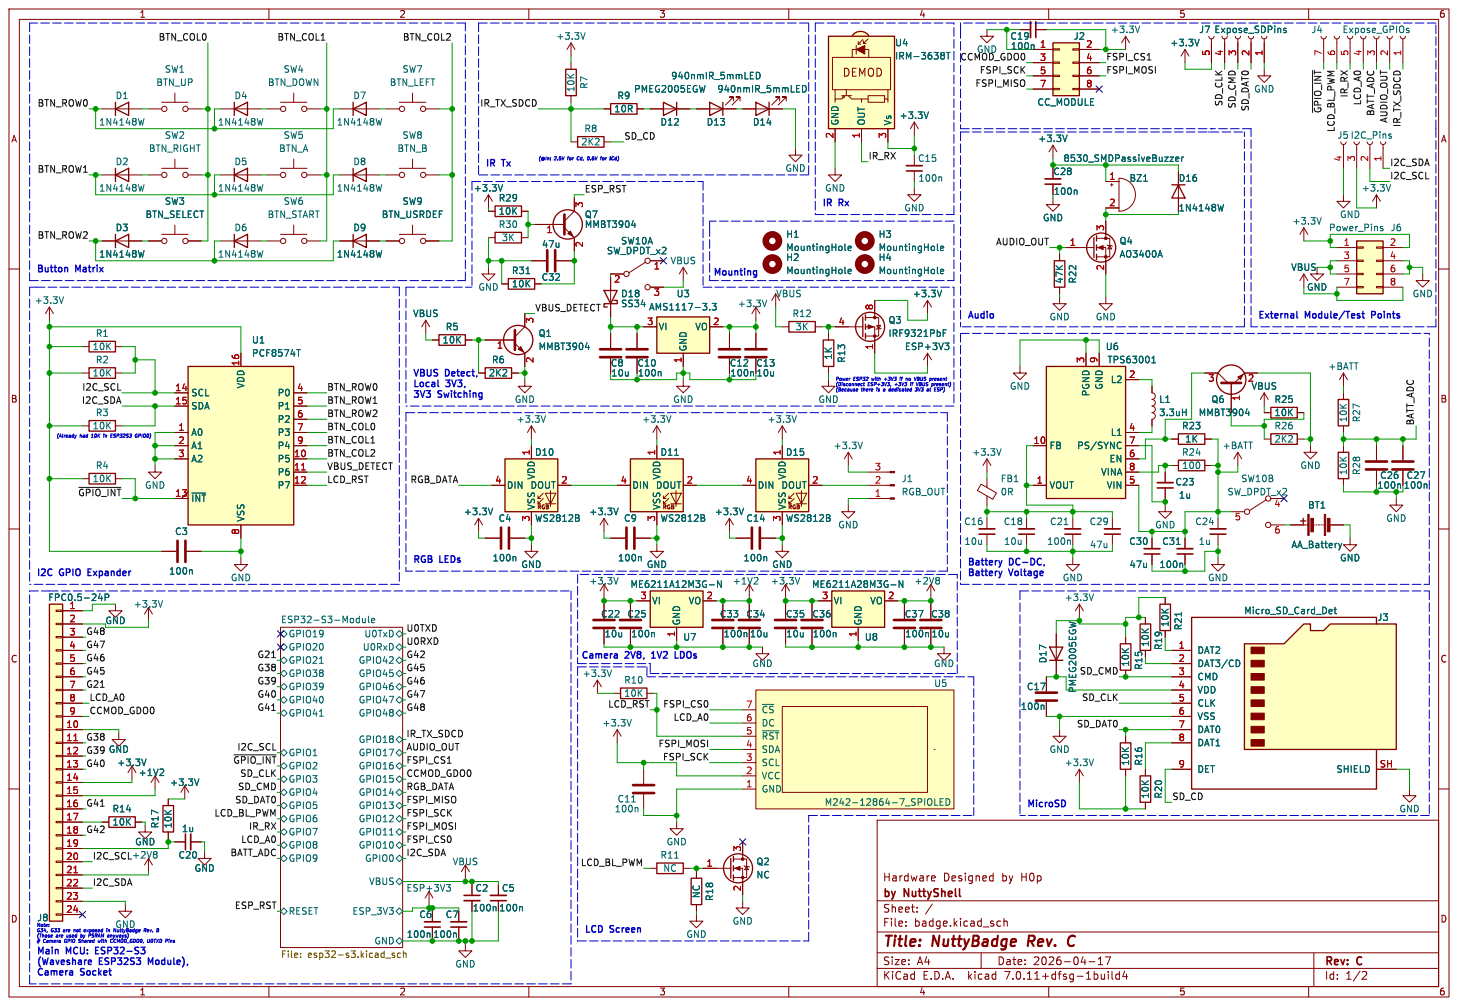
[picture p5: page 1]

(@In: 2.5V for Cd, 0.6V for !Cd)

U6TPS63001 VOUT 1 FB 10
L1 4 VIN 5 EN 6 PS/SYNC 7 VINA 8 GND

9 U6TPS63001 R23

Id: 1/2 Title: NuttyBadge Rev. C

(Those are used by PSRAM anyways) # Camera GPIO Shared with CCMOD_GDO0, U0TXD Pins

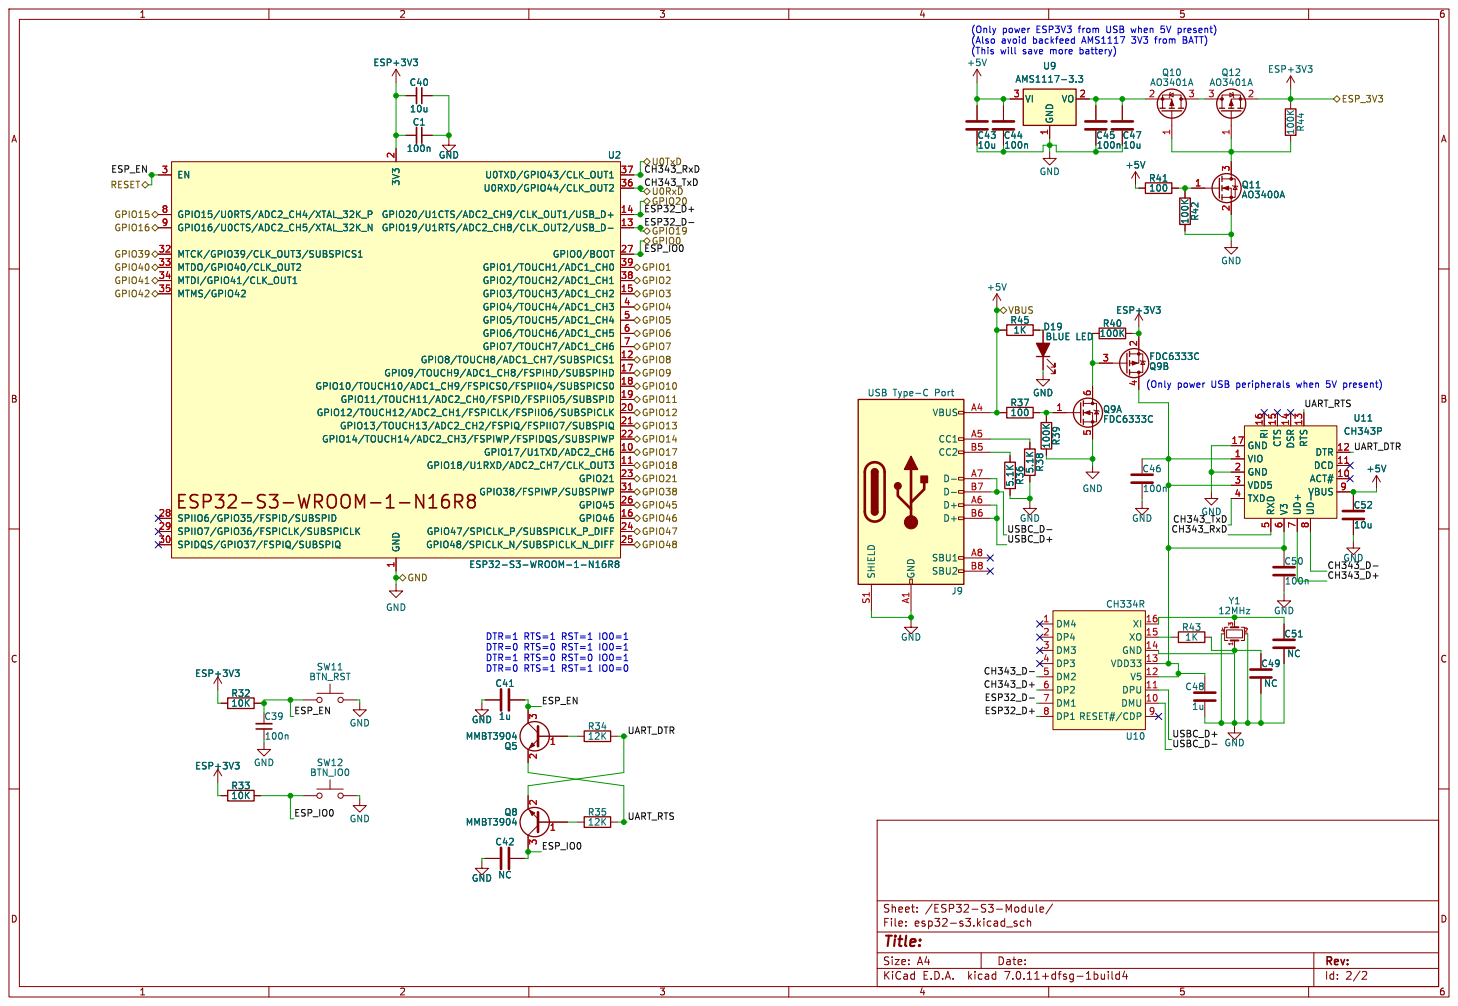
[picture p6: page 2]

(Only power ESP3V3 from USB when 5V present)
(Also avoid backfeed AMS1117 3V3 from BATT)
1K GND

(This will save more battery) DTR=1 RTS=1 RST=1 IO0=1 DTR=0 RTS=0 RST=1 IO0=1 DTR=1 RTS=0 RST=0 IO0=1 DTR=0 RTS=1 RST=1 IO0=0
