NuttyShell/NuttyBadge/NuttyHardware/mass_production_revb/badge.pdf

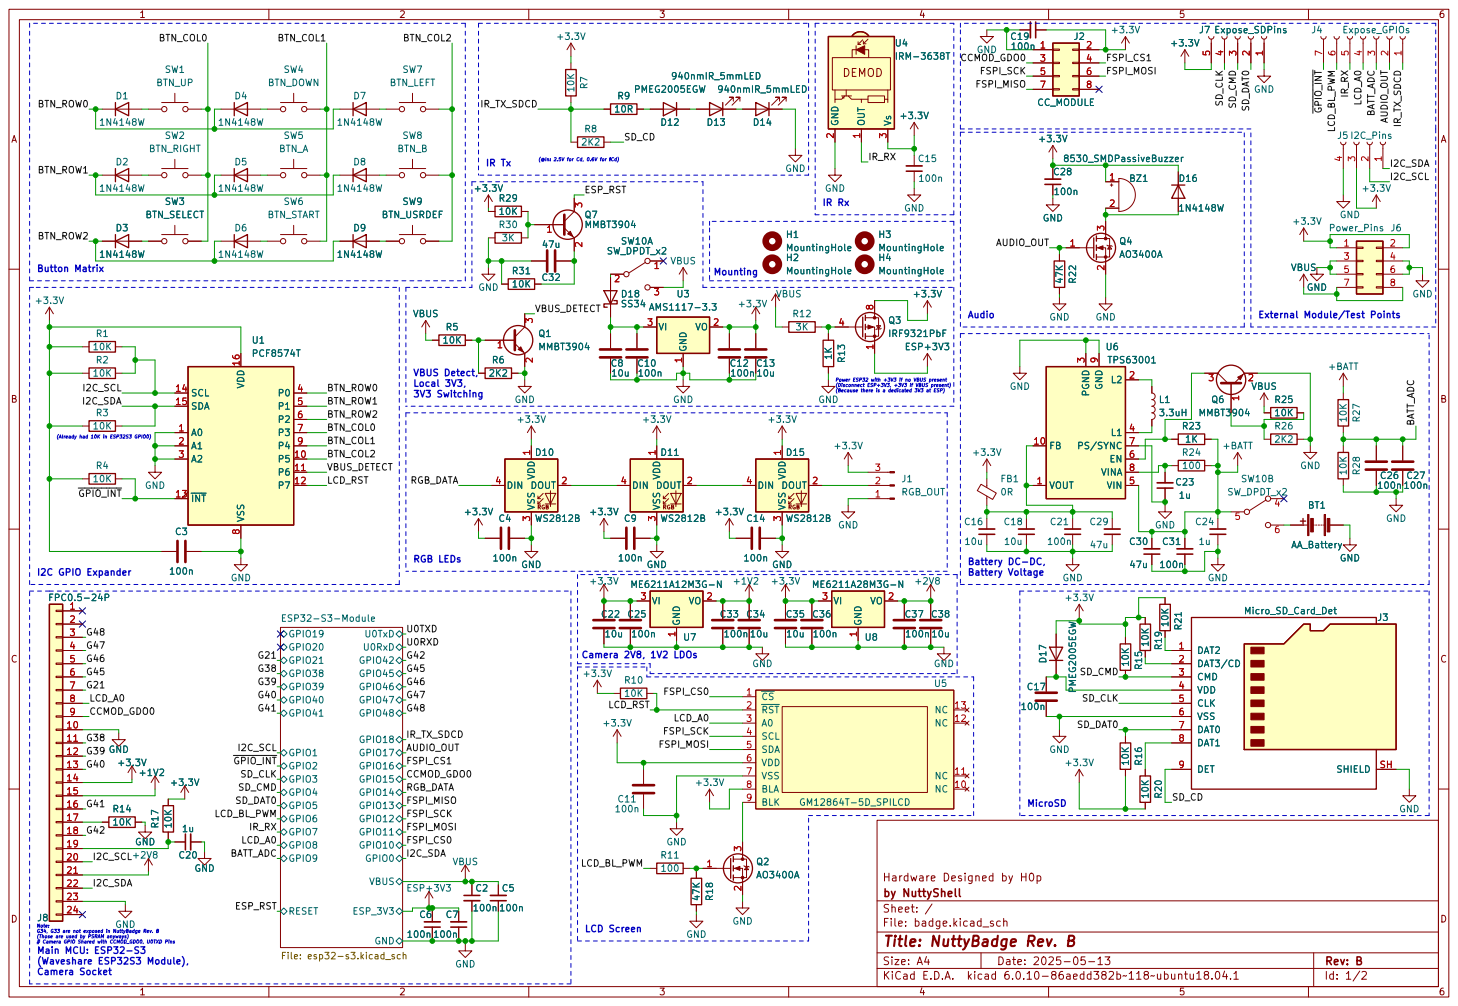
[picture p7: page 1]

IR Tx Main MCU: ESP32-S3

(@In: 2.5V for Cd, 0.6V for !Cd)

(Because there is a dedicated 3V3 at ESP) Mounting

Power ESP32 with +3V3 if no VBUS present (Disconnect ESP+3V3, +3V3 if VBUS present)

1 VO 2 VI 3 U8 ME6211A28M3G-N 47K R18 GND GND

File: badge.kicad_sch Sheet: / by NuttyShell

Id: 1/2 Title: NuttyBadge Rev. B

Note: G34, G33 are not exposed in NuttyBadge Rev. B

(Those are used by PSRAM anyways) # Camera GPIO Shared with CCMOD_GDO0, U0TXD Pins

(Waveshare ESP32S3 Module), Camera Socket

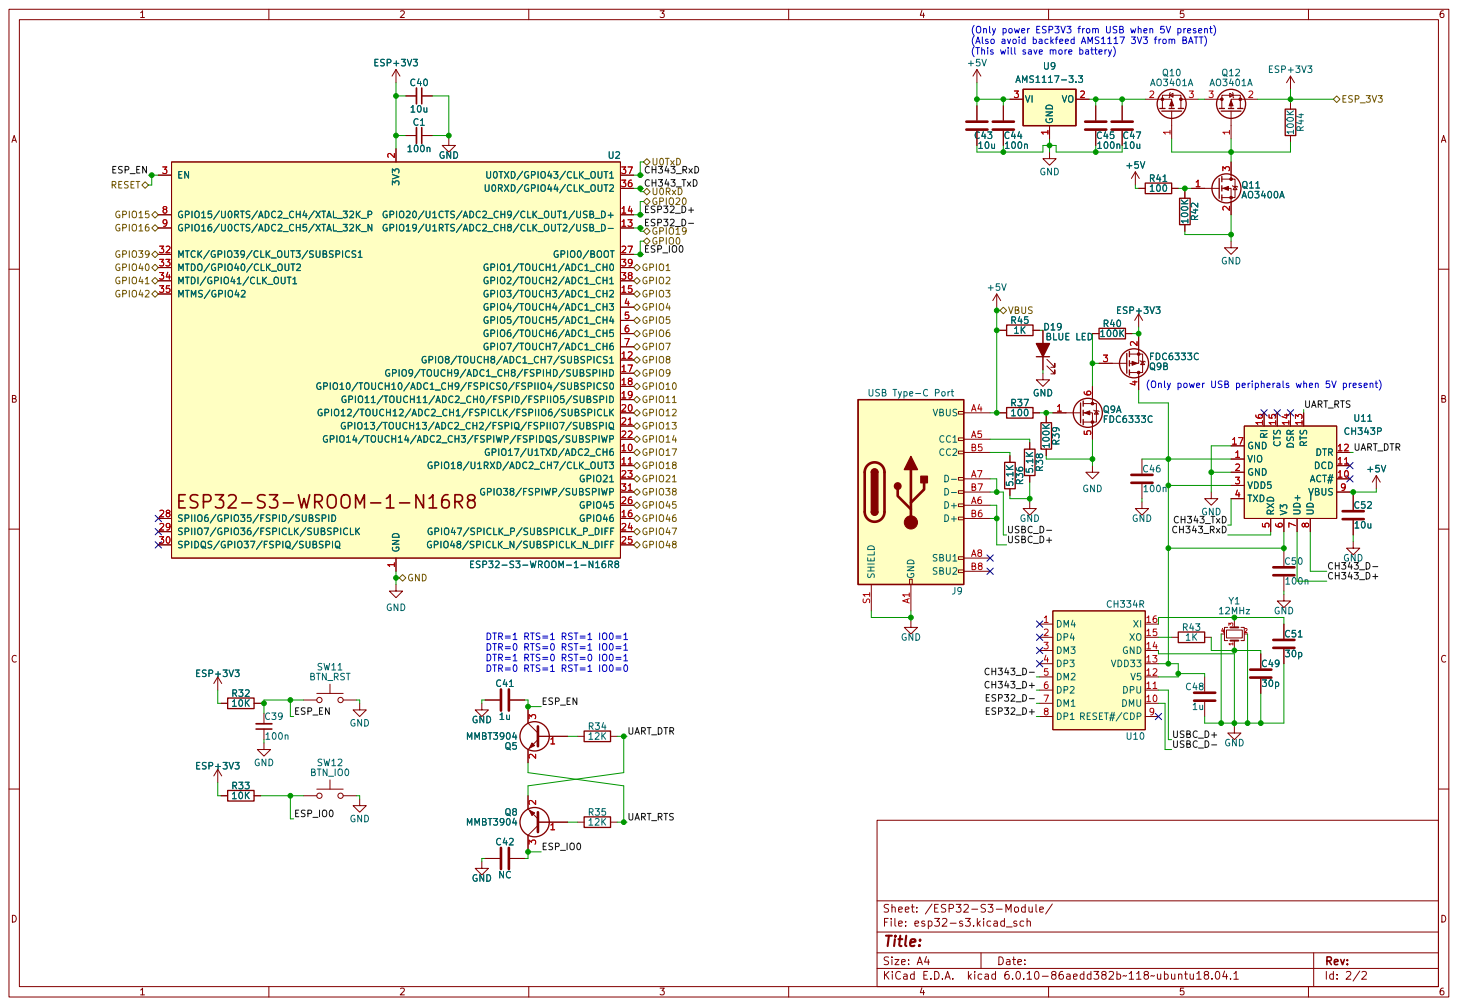
[picture p8: page 2]

(Only power ESP3V3 from USB when 5V present)
(Also avoid backfeed AMS1117 3V3 from BATT)
(This will save more battery)

(Only power USB peripherals when 5V present) DTR=1 RTS=1 RST=1 IO0=1 DTR=0 RTS=0 RST=1 IO0=1 DTR=1 RTS=0 RST=0 IO0=1 DTR=0 RTS=1 RST=1 IO0=0
