NuttyShell/NuttyBadge/NuttyHardware/mass_production_reva/badge.pdf

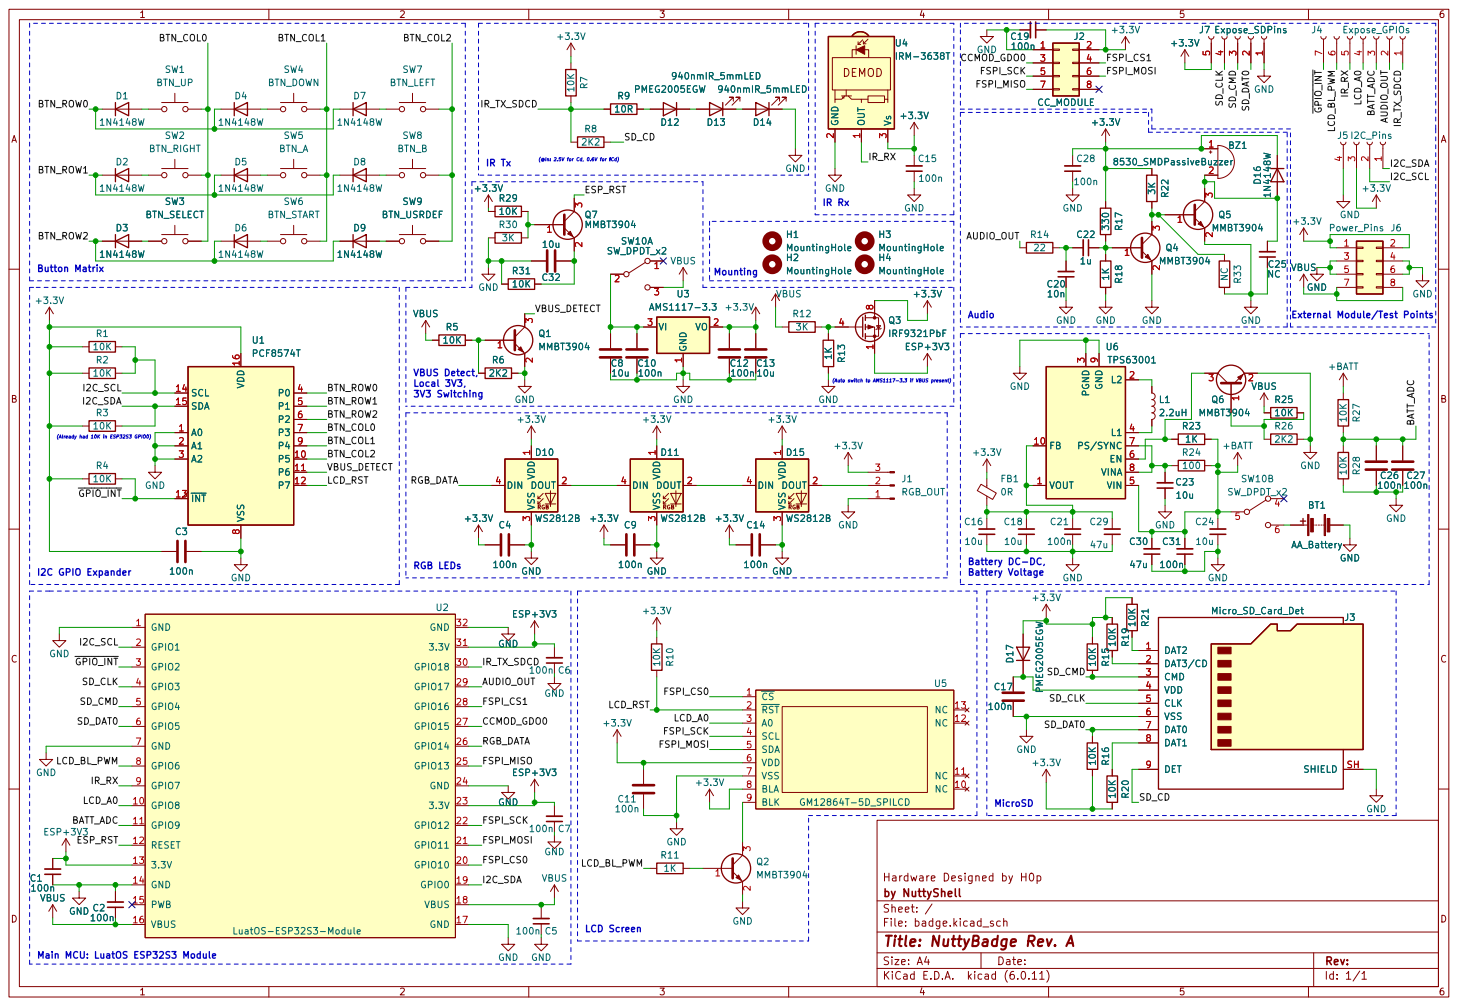
[picture p9: page 1]

Id: 1/1 Title: NuttyBadge Rev. A
