NuttyShell/NuttyBadge/NuttyHardware/badge.kicad_pcb

## KiCad design NuttyHardware/badge.kicad_pcb (2024-06-05)

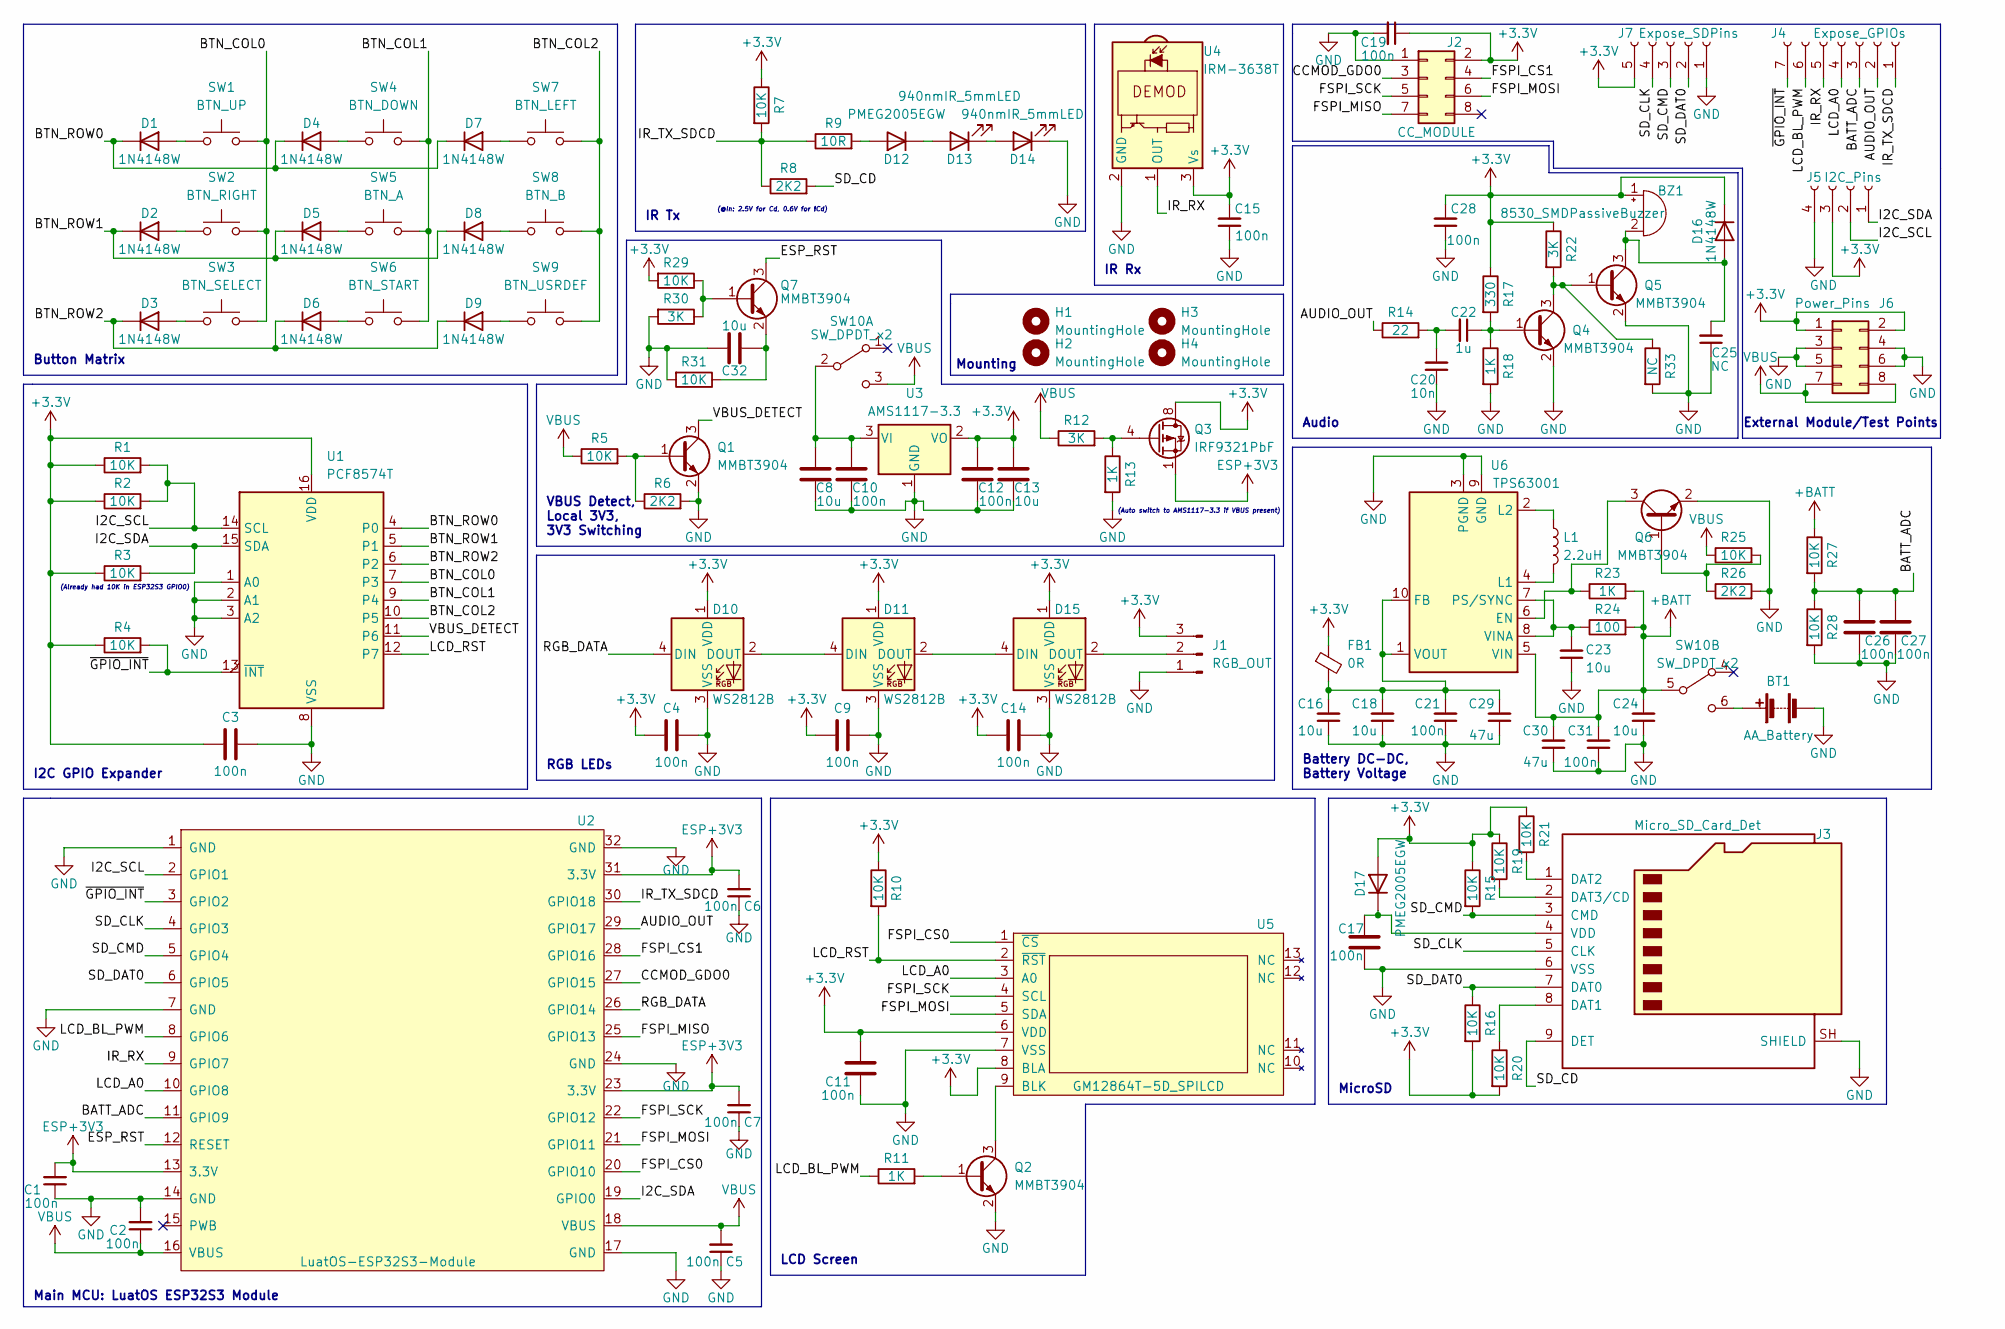
[picture p10: schematic badge.kicad_sch, NuttyBadge Rev. A]

Parts:
BT1: AA_Battery; BatteryHolder_2AA
BZ1: 8530_SMDPassiveBuzzer; MagneticBuzzer_Kobitone_254-EMB84Q-RO
C1, C2, C3, C4, C5, C6, C7, C9, C10, C11, C12, C14, C15, C17, C19, C21, C26, C27, C28, C31: 100n; C_1206_3216Metric_Pad1.33x1.80mm_HandSolder
C8, C13, C16, C18, C23, C24, C32: 10u; C_1206_3216Metric_Pad1.33x1.80mm_HandSolder
C20: 10n; C_1206_3216Metric_Pad1.33x1.80mm_HandSolder
C22: 1u; C_1206_3216Metric_Pad1.33x1.80mm_HandSolder
C25: NC; C_1206_3216Metric_Pad1.33x1.80mm_HandSolder
C29, C30: 47u; C_1206_3216Metric_Pad1.33x1.80mm_HandSolder
D1, D2, D3, D4, D5, D6, D7, D8, D9, D16: 1N4148W; D_SOD-123-BigDiodeSilkscreen
D10, D11, D15: WS2812B; LED_WS2812B_PLCC4_5.0x5.0mm_P3.2mm-TriangleSilkscreen
D12, D17: PMEG2005EGW; D_SOD-123-BigDiodeSilkscreen
D13, D14: 940nmIR_5mmLED; LED_D5.0mm_Horizontal_O3.81mm_Z3.0mm
FB1: 0R; L_1206_3216Metric_Pad1.42x1.75mm_HandSolder
H1, H2, H3, H4: MountingHole; MountingHole_3.2mm_M3_ISO7380
J1: RGB_OUT; PinHeader_1x03_P2.54mm_Vertical
J2: CC_MODULE; PinSocket_2x04_P2.54mm_Vertical_PinNumberFlipped
J3: Micro_SD_Card_Det; Conn_uSDcard
J4: Expose_GPIOs; PinHeader_1x07_P2.54mm_Vertical
J5: I2C_Pins; PinSocket_1x04_P2.54mm_Vertical
J6: Power_Pins; PinSocket_2x04_P2.54mm_Vertical_PinNumberFlipped
J7: Expose_SDPins; PinHeader_1x05_P2.54mm_Vertical
L1: 2.2uH; L_Wuerth_HCI-1040
Q1, Q2, Q4, Q5, Q6, Q7: MMBT3904; SOT-23
Q3: IRF9321PbF; SOIC-8_3.9x4.9mm_P1.27mm
R1, R2, R3, R4, R5, R7, R10, R15, R16, R19, R20, R21, R25, R27, R28, R29, R31: 10K; R_1206_3216Metric_Pad1.30x1.75mm_HandSolder
R6, R8, R26: 2K2; R_1206_3216Metric_Pad1.30x1.75mm_HandSolder
R9: 10R; R_1206_3216Metric_Pad1.30x1.75mm_HandSolder
R11, R13, R18, R23: 1K; R_1206_3216Metric_Pad1.30x1.75mm_HandSolder
R12, R22, R30: 3K; R_1206_3216Metric_Pad1.30x1.75mm_HandSolder
R14: 22; R_1206_3216Metric_Pad1.30x1.75mm_HandSolder
R17: 330; R_1206_3216Metric_Pad1.30x1.75mm_HandSolder
R24: 100; R_1206_3216Metric_Pad1.30x1.75mm_HandSolder
R33: NC; R_1206_3216Metric_Pad1.30x1.75mm_HandSolder
SW1: BTN_UP; SW_Push_1P1T_NO_CK_PTS125Sx43PSMTR_NoHoles
SW2: BTN_RIGHT; SW_Push_1P1T_NO_CK_PTS125Sx43PSMTR_NoHoles
SW3: BTN_SELECT; SW_Push_1P1T_NO_CK_PTS125Sx43PSMTR_NoHoles
SW4: BTN_DOWN; SW_Push_1P1T_NO_CK_PTS125Sx43PSMTR_NoHoles
SW5: BTN_A; SW_Push_1P1T_NO_CK_PTS125Sx43PSMTR_NoHoles
SW6: BTN_START; SW_Push_1P1T_NO_CK_PTS125Sx43PSMTR_NoHoles
SW7: BTN_LEFT; SW_Push_1P1T_NO_CK_PTS125Sx43PSMTR_NoHoles
SW8: BTN_B; SW_Push_1P1T_NO_CK_PTS125Sx43PSMTR_NoHoles
SW9: BTN_USRDEF; SW_Push_1P1T_NO_CK_PTS125Sx43PSMTR_NoHoles
SW10: SW_DPDT_x2; SW_DPDT_Power_Switch
U1: PCF8574T; SOIC-16W_7.5x10.3mm_P1.27mm
U2: LuatOS-ESP32S3-Module; Module_ESP32S3_LuatOS
U3: AMS1117-3.3; SOT-223-3_TabPin2
U4: IRM-3638T; Vishay_MINICAST-3Pin
U5: GM12864T-5D_SPILCD; GM12864T-5D
U6: TPS63001; Texas_DRC0010J_ThermalVias_LargeHoles

Connections:
+3.3V: BZ1.1 (-), C3.1, C4.1, C9.1, C11.2, C12.2, C13.2, C14.1, C15.2, C19.1, C28.2, D10.1 (VDD), D11.1 (VDD), D15.1 (VDD), D16.1 (K), D17.2 (A), FB1.1, J1.3, J2.2, J5.3, J6.1, J6.2, J7.5, Q3.5 (D), Q3.6 (D), Q3.7 (D), Q3.8 (D), R1.1, R2.1, R3.1, R4.1, R7.1, R10.1, R15.1, R16.2, R17.1, R19.1, R20.2, R21.1, R22.1, R29.2, U1.16 (VDD), U3.2 (VO), U4.3 (Vs), U5.6 (VDD), U5.8 (BLA)
+BATT: C24.2, C30.2, C31.2, R23.2, R24.2, R27.1, SW10.5 (B), U6.5 (VIN)
/AUDIO_OUT: J4.2, R14.1, U2.29 (GPIO17)
/BATT_ADC: C26.2, C27.2, J4.3, R27.2, R28.1, U2.11 (GPIO9)
/BTN_COL0: SW1.2, SW2.2, SW3.2, U1.7 (P3)
/BTN_COL1: SW4.2, SW5.2, SW6.2, U1.9 (P4)
/BTN_COL2: SW7.2, SW8.2, SW9.2, U1.10 (P5)
/BTN_ROW0: D1.1 (K), D4.1 (K), D7.1 (K), U1.4 (P0)
/BTN_ROW1: D2.1 (K), D5.1 (K), D8.1 (K), U1.5 (P1)
/BTN_ROW2: D3.1 (K), D6.1 (K), D9.1 (K), U1.6 (P2)
/CCMOD_GDO0: J2.3, U2.27 (GPIO15)
/ESP_RST: Q7.3 (C), U2.12 (RESET)
/FSPI_CS0: U2.20 (GPIO10), U5.1 (~CS)
/FSPI_CS1: J2.4, U2.28 (GPIO16)
/FSPI_MISO: J2.7, U2.25 (GPIO13)
/FSPI_MOSI: J2.6, U2.21 (GPIO11), U5.5 (SDA)
/FSPI_SCK: J2.5, U2.22 (GPIO12), U5.4 (SCL)
/I2C_SCL: J5.2, R1.2, R2.2, U1.14 (SCL), U2.2 (GPIO1)
/I2C_SDA: J5.1, R3.2, U1.15 (SDA), U2.19 (GPIO0)
/IR_RX: J4.5, U2.9 (GPIO7), U4.1 (OUT)
/IR_TX_SDCD: J4.1, R7.2, R8.1, R9.1, U2.30 (GPIO18)
/LCD_A0: J4.4, U2.10 (GPIO8), U5.3 (A0)
/LCD_BL_PWM: J4.6, R11.1, U2.8 (GPIO6)
/LCD_RST: R10.2, U1.12 (P7), U5.2 (~RST)
/RGB_DATA: D10.4 (DIN), U2.26 (GPIO14)
/SD_CD: J3.9 (DET), R8.2
/SD_CLK: J3.5 (CLK), J7.4, U2.4 (GPIO3)
/SD_CMD: J3.3 (CMD), J7.3, R15.2, U2.5 (GPIO4)
/SD_DAT0: J3.7 (DAT0), J7.2, R16.1, U2.6 (GPIO5)
/VBUS_DETECT: Q1.3 (C), U1.11 (P6)
/~GPIO_INT: J4.7, R4.2, U1.13 (~INT), U2.3 (GPIO2)
ESP+3V3: C1.2, C6.2, C7.2, Q3.1 (S), Q3.2 (S), Q3.3 (S), U2.13 (3.3V), U2.23 (3.3V), U2.31 (3.3V)
GND: BT1.2 (-), C1.1, C2.2, C3.2, C4.2, C5.1, C6.1, C7.1, C8.1, C9.2, C10.1, C11.1, C12.1, C13.1, C14.2, C15.1, C16.1, C17.1, C18.1, C19.2, C20.1, C21.1, C23.1, C24.1, C25.1, C26.1, C27.1, C28.1, C29.1, C30.1, C31.1, C32.1, D10.3 (VSS), D11.3 (VSS), D14.1 (K), D15.3 (VSS), J1.1, J2.1, J3.6 (VSS), J3.SH (SHIELD), J5.4, J6.3, J6.4, J6.5, J6.6, J7.1, Q1.2 (E), Q2.2 (E), Q4.2 (E), Q5.2 (E), Q6.2 (E), R6.2, R13.2, R18.2, R26.2, R28.2, R30.2, R31.2, R33.2, U1.1 (A0), U1.2 (A1), U1.3 (A2), U1.8 (VSS), U2.1 (GND), U2.7 (GND), U2.14 (GND), U2.17 (GND), U2.24 (GND), U2.32 (GND), U3.1 (GND), U4.2 (GND), U5.7 (VSS), U6.3 (PGND), U6.9 (GND), U6.11 (PGND)
unnamed: BT1.1 (+), SW10.6 (C)
unnamed: BZ1.2 (+), C25.2, D16.2 (A), Q5.3 (C)
unnamed: C8.2, C10.2, SW10.2 (B), U3.3 (VI)
unnamed: C16.2, C18.2, C21.2, C29.2, FB1.2, U6.1 (VOUT), U6.10 (FB)
unnamed: C17.2, D17.1 (K), J3.4 (VDD)
unnamed: C20.2, C22.2, R14.2
unnamed: C22.1, Q4.1 (B), R17.2, R18.1
unnamed: C23.2, R24.1, U6.7 (PS/SYNC), U6.8 (VINA)
unnamed: C32.2, Q7.2 (E), R31.1
unnamed: D1.2 (A), SW1.1
unnamed: D2.2 (A), SW2.1
unnamed: D3.2 (A), SW3.1
unnamed: D4.2 (A), SW4.1
unnamed: D5.2 (A), SW5.1
unnamed: D6.2 (A), SW6.1
unnamed: D7.2 (A), SW7.1
unnamed: D8.2 (A), SW8.1
unnamed: D9.2 (A), SW9.1
unnamed: D10.2 (DOUT), D11.4 (DIN)
unnamed: D11.2 (DOUT), D15.4 (DIN)
unnamed: D12.1 (K), D13.2 (A)
unnamed: D12.2 (A), R9.2
unnamed: D13.1 (K), D14.2 (A)
unnamed: D15.2 (DOUT), J1.2
unnamed: J3.1 (DAT2), R21.2
unnamed: J3.2 (DAT3/CD), R19.2
unnamed: J3.8 (DAT1), R20.1
unnamed: L1.1, U6.2 (L2)
unnamed: L1.2, U6.4 (L1)
unnamed: Q1.1 (B), R5.2, R6.1
unnamed: Q2.1 (B), R11.2
unnamed: Q2.3 (C), U5.9 (BLK)
unnamed: Q3.4 (G), R12.2, R13.1
unnamed: Q4.3 (C), Q5.1 (B), R22.2, R33.1
unnamed: Q6.1 (B), R25.2, R26.1
unnamed: Q6.3 (C), R23.1, U6.6 (EN)
unnamed: Q7.1 (B), R29.1, R30.1
VBUS: C2.1, C5.2, J6.7, J6.8, R5.1, R12.1, R25.1, SW10.3 (C), U2.16 (VBUS), U2.18 (VBUS)

Notes on the sheet:
Button Matrix
IR Rx
(@In: 2.5V for Cd, 0.6V for !Cd)
(Already had 10K in ESP32S3 GPIO0)
External Module/Test Points
Battery DC-DC, Battery Voltage
Main MCU: LuatOS ESP32S3 Module
Mounting
Audio
VBUS Detect, Local 3V3, 3V3 Switching
IR Tx
MicroSD
LCD Screen
(Auto switch to AMS1117-3.3 if VBUS present)
I2C GPIO Expander
RGB LEDs

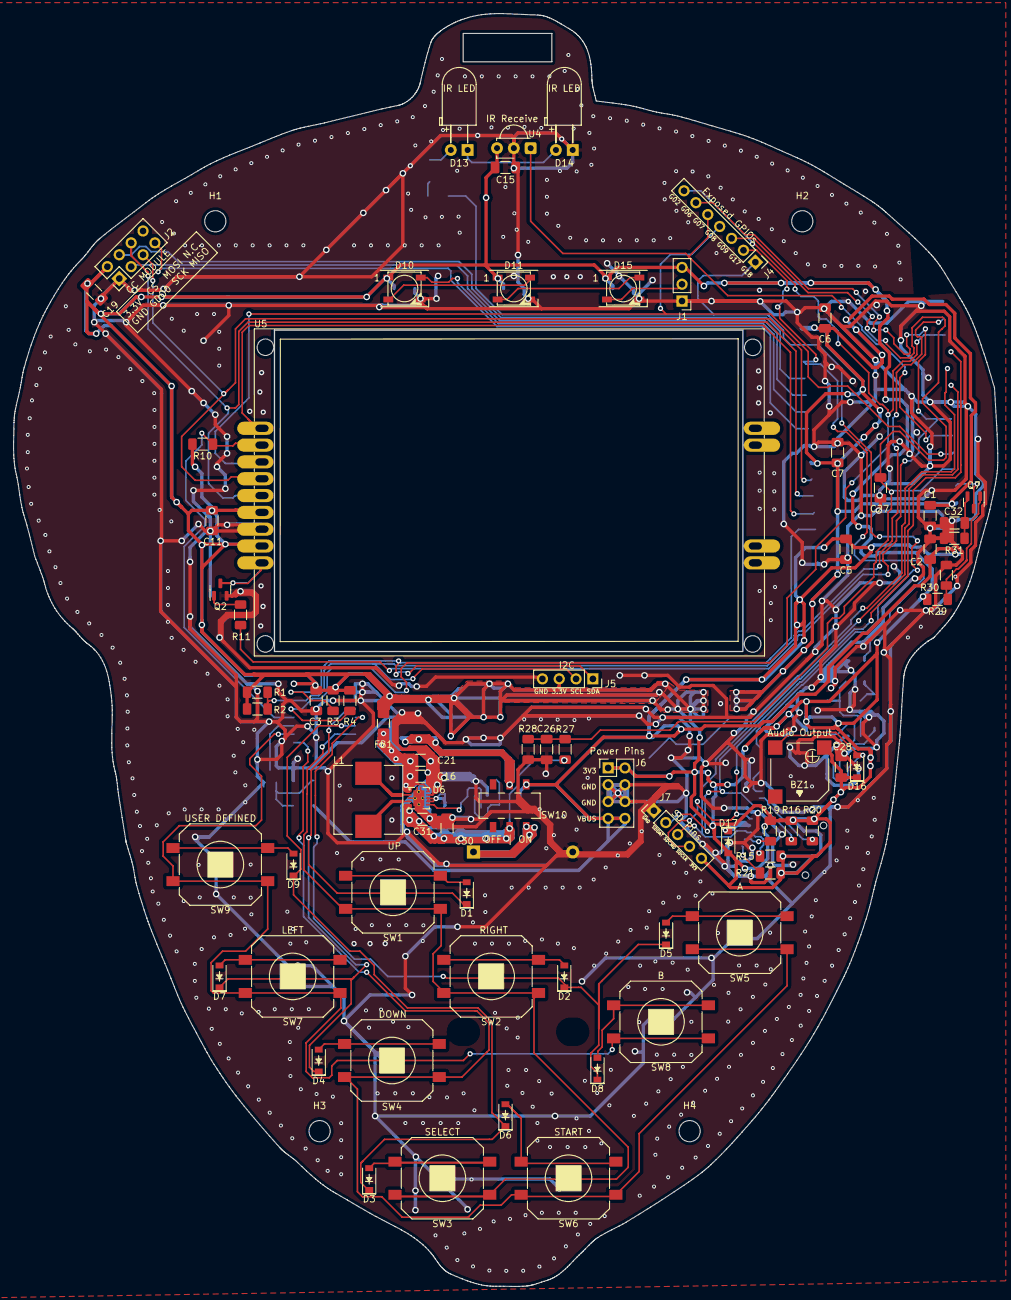
[picture p11: board badge.kicad_pcb from above]

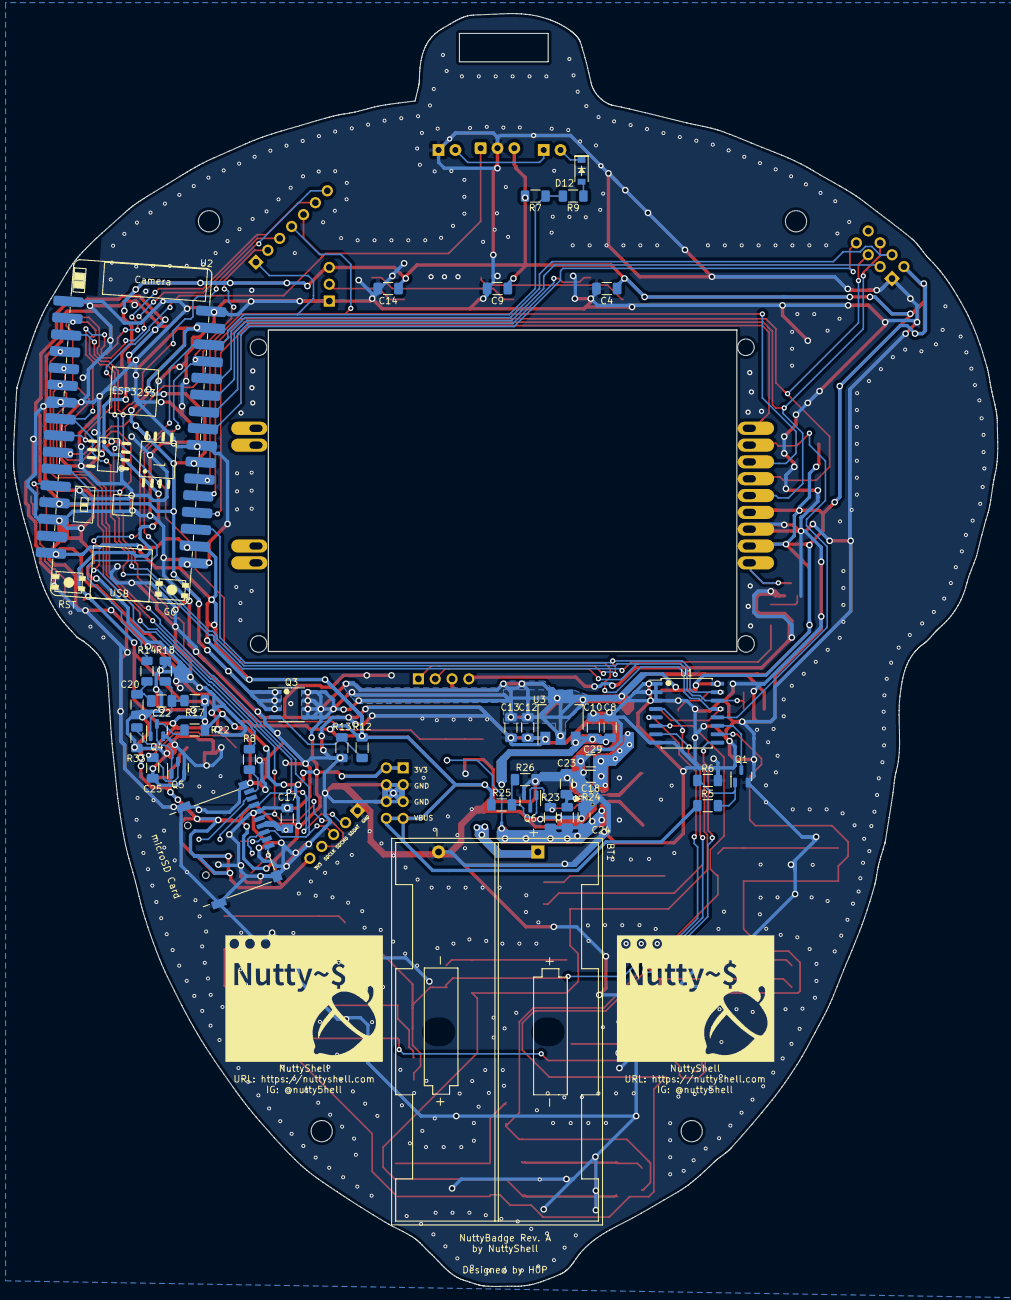
[picture p12: board badge.kicad_pcb from below]

Board: 2 copper layers, 148.6 x 192.2 mm, 119 parts (42 on the bottom side), 71 nets.
