NuttyShell/NuttyBadge/NuttyOS/main/drivers/pwm_audio.c

/* SPDX-FileCopyrightText: 2022-2023 Espressif Systems (Shanghai) CO LTD
 *
 * SPDX-License-Identifier: Apache-2.0
 */

#include <inttypes.h>
#include <string.h>
#include "freertos/FreeRTOS.h"
#include "freertos/semphr.h"
#include "esp_log.h"
#include "soc/ledc_struct.h"
#include "pwm_audio.h"

static const char *TAG = "pwm_audio";

#define PWM_AUDIO_CHECK(a, str, ret_val)                          \
    if (!(a))                                                     \
    {                                                             \
        ESP_LOGE(TAG, "%s(%d): %s", __FUNCTION__, __LINE__, str); \
        return (ret_val);                                         \
    }

static const char *PWM_AUDIO_PARAM_ADDR_ERROR = "PWM AUDIO PARAM ADDR ERROR";
static const char *PWM_AUDIO_FRAMERATE_ERROR  = "PWM AUDIO FRAMERATE ERROR";
static const char *PWM_AUDIO_STATUS_ERROR     = "PWM AUDIO STATUS ERROR";
static const char *PWM_AUDIO_ALLOC_ERROR      = "PWM AUDIO ALLOC ERROR";
static const char *PWM_AUDIO_RESOLUTION_ERROR = "PWM AUDIO RESOLUTION ERROR";
static const char *PWM_AUDIO_NOT_INITIALIZED  = "PWM AUDIO Uninitialized";

#define BUFFER_MIN_SIZE     (256UL)
#define SAMPLE_RATE_MAX     (48000)
#define SAMPLE_RATE_MIN     (8000)
#define CHANNEL_LEFT_INDEX  (0)
#define CHANNEL_LEFT_MASK   (0x01)
#define CHANNEL_RIGHT_MASK  (0x02)
#define MAX_VOLUME          (48)   // TODO: This value is obtained from testing, could be optimized in the future.

#ifndef TIMER_BASE_CLK
#define TIMER_BASE_CLK 80000000
#endif
#define TIMER_DIVIDER  2

/**
 * Debug Configuration
 **/
#define ISR_DEBUG 0  /**< INDEBUG SWITCH */
#define ISR_DEBUG_IO_MASK 0x8000

typedef struct {
    char *buf;                         /**< Original pointer */
    volatile uint32_t head;            /**< ending pointer */
    volatile uint32_t tail;            /**< Read pointer */
    volatile uint32_t size;            /**< Buffer size */
    volatile uint32_t is_give;         /**< semaphore give flag */
    SemaphoreHandle_t semaphore_rb;    /**< Semaphore for ringbuffer */
} ringbuf_handle_t;

typedef struct {
    pwm_audio_config_t    config;                          /**< pwm audio config struct */
    ledc_channel_config_t ledc_channel[PWM_AUDIO_CH_MAX];  /**< ledc channel config */
    ledc_timer_config_t   ledc_timer;                      /**< ledc timer config  */
    ringbuf_handle_t      *ringbuf;                        /**< audio ringbuffer pointer */
    uint32_t              channel_mask;                    /**< channel gpio mask */
    uint32_t              channel_set_num;                 /**< channel audio set number */
    int32_t               framerate;                       /*!< frame rates in Hz */
    int32_t               bits_per_sample;                 /*!< bits per sample (8, 16, 32) */
    int32_t               volume;                          /*!< the volume */
    pwm_audio_status_t status;
} pwm_audio_data_t;

/**< ledc some register pointer */
static volatile uint32_t *g_ledc_left_conf0_val  = NULL;
static volatile uint32_t *g_ledc_left_conf1_val  = NULL;
static volatile uint32_t *g_ledc_left_duty_val   = NULL;

/**< pwm audio handle pointer */
static pwm_audio_data_t *g_pwm_audio_handle = NULL;

#if ESP_IDF_VERSION >= ESP_IDF_VERSION_VAL(5, 0, 0)
static gptimer_handle_t g_gptimer;
#endif

/**
 * Ringbuffer for pwm audio
 */
static esp_err_t rb_destroy(ringbuf_handle_t *rb)
{
    if (rb == NULL) {
        return ESP_ERR_INVALID_ARG;
    }

    if (rb->buf) {
        heap_caps_free(rb->buf);
    }

    if (rb->semaphore_rb) {
        vSemaphoreDelete(rb->semaphore_rb);
    }

    heap_caps_free(rb);
    rb = NULL;
    return ESP_OK;
}

static ringbuf_handle_t *rb_create(uint32_t size)
{
    if (size < (BUFFER_MIN_SIZE << 2)) {
        ESP_LOGE(TAG, "Invalid buffer size, Minimum = %"PRIi32"", (int32_t)(BUFFER_MIN_SIZE << 2));
        return NULL;
    }

    ringbuf_handle_t *rb = NULL;
    char *buf = NULL;

    do {
        bool _success =
            (
                (rb             = heap_caps_malloc(sizeof(ringbuf_handle_t), MALLOC_CAP_8BIT | MALLOC_CAP_INTERNAL)) &&
                (buf            = heap_caps_malloc(size, MALLOC_CAP_8BIT | MALLOC_CAP_INTERNAL))   &&
                (rb->semaphore_rb   = xSemaphoreCreateBinary())

            );

        if (!_success) {
            break;
        }

        rb->is_give = 0;
        rb->buf = buf;
        rb->head = rb->tail = 0;
        rb->size = size;
        return rb;

    } while (0);

    rb_destroy(rb);
    return NULL;
}

static uint32_t IRAM_ATTR rb_get_count(ringbuf_handle_t *rb)
{
    uint32_t tail = rb->tail;

    if (rb->head >= tail) {
        return (rb->head - tail);
    }

    return (rb->size - (tail - rb->head));
}

static uint32_t IRAM_ATTR rb_get_free(ringbuf_handle_t *rb)
{
    /** < Free a byte to judge the ringbuffer direction */
    return (rb->size - rb_get_count(rb) - 1);
}

static esp_err_t rb_flush(ringbuf_handle_t *rb)
{
    rb->tail = rb->head = 0;
    return ESP_OK;
}

static esp_err_t IRAM_ATTR rb_read_byte(ringbuf_handle_t *rb, uint8_t *outdata)
{
    uint32_t tail = rb->tail;

    if (tail == rb->head) {
        return ESP_FAIL;
    }

    // Send a byte from the buffer
    *outdata = rb->buf[tail];

    // Update tail position
    tail++;

    if (tail == rb->size) {
        tail = 0;
    }

    rb->tail = tail;
    return ESP_OK;
}

static esp_err_t rb_write_byte(ringbuf_handle_t *rb, const uint8_t indata)
{
    // Calculate next head
    uint32_t next_head = rb->head + 1;

    if (next_head == rb->size) {
        next_head = 0;
    }

    if (next_head == rb->tail) {
        return ESP_FAIL;
    }

    // Store data and advance head
    rb->buf[rb->head] = (indata);
    rb->head = next_head;
    return ESP_OK;
}

static esp_err_t rb_wait_semaphore(ringbuf_handle_t *rb, TickType_t ticks_to_wait)
{
    rb->is_give = 0; /**< As long as it's written, it's allowed to give semaphore again */

    if (xSemaphoreTake(rb->semaphore_rb, ticks_to_wait) == pdTRUE) {
        return ESP_OK;
    }

    return ESP_FAIL;
}

/*
 * Note:
 * In order to improve efficiency, register is operated directly
 */
static inline void ledc_set_left_duty_fast(uint32_t duty_val)
{
    *g_ledc_left_duty_val = (duty_val) << 4; /* Discard decimal part */
    *g_ledc_left_conf0_val |= 0x00000014;
    *g_ledc_left_conf1_val |= 0x80000000;
}


/*
 * Timer group ISR handler
 */

static bool IRAM_ATTR timer_group_isr(gptimer_handle_t timer, const gptimer_alarm_event_data_t *edata, void *user_ctx)
{
    pwm_audio_data_t *handle = g_pwm_audio_handle;
    if (handle == NULL) {
        return false;
    }

    static uint8_t wave_h, wave_l;
    static uint16_t value;
    ringbuf_handle_t *rb = handle->ringbuf;
#if (1==ISR_DEBUG)
    GPIO.out_w1ts = ISR_DEBUG_IO_MASK;
#endif

    /**
     * It is believed that the channel configured with GPIO needs to output sound
    */
    if (handle->channel_mask & CHANNEL_LEFT_MASK) {
        if (handle->config.duty_resolution > 8) {
            if (rb_get_count(rb) > 1) {
                rb_read_byte(rb, &wave_l);
                rb_read_byte(rb, &wave_h);
                value = ((wave_h << 8) | wave_l);
                ledc_set_left_duty_fast(value);/**< set the PWM duty */
            }
        } else {
            if (ESP_OK == rb_read_byte(rb, &wave_h)) {
                ledc_set_left_duty_fast(wave_h);/**< set the PWM duty */
            }
        }
    }

    /**
     * Send semaphore when buffer free is more than BUFFER_MIN_SIZE
     */
    uint32_t free_size = rb_get_free(rb);
    if (0 == rb->is_give && free_size > BUFFER_MIN_SIZE) {
        /**< The execution time of the following code is 2.71 microsecond */
        rb->is_give = 1; /**< To prevent multiple give semaphores */
        BaseType_t xHigherPriorityTaskWoken;
        xSemaphoreGiveFromISR(rb->semaphore_rb, &xHigherPriorityTaskWoken);

        if (pdFALSE != xHigherPriorityTaskWoken) {
            portYIELD_FROM_ISR();
        }
    }
#if (1==ISR_DEBUG)
    GPIO.out_w1tc = ISR_DEBUG_IO_MASK;
#endif
    return true;
}

esp_err_t pwm_audio_get_status(pwm_audio_status_t *status)
{
    pwm_audio_data_t *handle = g_pwm_audio_handle;
    PWM_AUDIO_CHECK(NULL != handle, PWM_AUDIO_NOT_INITIALIZED, ESP_ERR_INVALID_STATE);
    *status = handle->status;
    return ESP_OK;
}

esp_err_t pwm_audio_get_param(int *rate, int *bits, int *ch)
{
    pwm_audio_data_t *handle = g_pwm_audio_handle;
    PWM_AUDIO_CHECK(NULL != handle, PWM_AUDIO_NOT_INITIALIZED, ESP_ERR_INVALID_STATE);

    if (NULL != rate) {
        *rate = handle->framerate;
    }

    if (NULL != bits) {
        *bits = (int)handle->bits_per_sample;
    }

    if (NULL != ch) {
        *ch = handle->channel_set_num;
    }

    return ESP_OK;
}

void pwm_audio_reset_freq() {
    // FIXME: Use 8-bit first
    uint32_t freq = (APB_CLK_FREQ / (1 << g_pwm_audio_handle->ledc_timer.duty_resolution));

    freq = 78000;
    
    ESP_LOGI(TAG, "Using FREQ: %lu, res=%d", freq, g_pwm_audio_handle->ledc_timer.duty_resolution);
    g_pwm_audio_handle->ledc_timer.freq_hz = freq - (freq % 1000); // fixed PWM frequency ,It's a multiple of 1000
    /*
     * We can actually calculate this frequency manually:
     * For ESP32S3, the APB clock is 80MHz.
     * If we set the duty resolution to 8-bit, the LEDC PWM frequency will be 80MHz / 256 = 312.5KHz
     * If we set the duty resolution to 10-bit, the LEDC PWM frequency will be 80MHz / 1024 = 78.125KHz.
     * To maximize the audio quality, actually we want to:
     * - Maximize PWM Frequency
     * - Minimize the quantization noise (which means we want higher resolution)
     * To balance this, we will use 10-bit PWM, then the LED PWM frequency will be 78.125KHz, which is still higher than the human audible range, and the quantization noise is much lower than 8-bit PWM.
     */
    
    //g_pwm_audio_handle->ledc_timer.freq_hz = 30000; // fixed PWM frequency ,It's a multiple of 1000
    ledc_timer_config(&g_pwm_audio_handle->ledc_timer);
}

esp_err_t pwm_audio_init(const pwm_audio_config_t *cfg)
{
    ESP_LOGI(TAG, "PWM Audio Version: %d.%d.%d",PWM_AUDIO_VER_MAJOR, PWM_AUDIO_VER_MINOR, PWM_AUDIO_VER_PATCH);
    esp_err_t res = ESP_OK;
    PWM_AUDIO_CHECK(cfg != NULL, PWM_AUDIO_PARAM_ADDR_ERROR, ESP_ERR_INVALID_ARG);
    PWM_AUDIO_CHECK(cfg->duty_resolution <= 10 && cfg->duty_resolution >= 8, PWM_AUDIO_RESOLUTION_ERROR, ESP_ERR_INVALID_ARG);
    PWM_AUDIO_CHECK(NULL == g_pwm_audio_handle, "Already initiate", ESP_ERR_INVALID_STATE);

    ESP_LOGI(TAG, "left io: %d | right io: %d | resolution: %dBIT",
             cfg->gpio_num_left, cfg->gpio_num_right, cfg->duty_resolution);


    pwm_audio_data_t *handle = NULL;

    handle = heap_caps_malloc(sizeof(pwm_audio_data_t), MALLOC_CAP_8BIT | MALLOC_CAP_INTERNAL);
    PWM_AUDIO_CHECK(handle != NULL, PWM_AUDIO_ALLOC_ERROR, ESP_ERR_NO_MEM);
    memset(handle, 0, sizeof(pwm_audio_data_t));

    handle->ringbuf = rb_create(cfg->ringbuf_len);
    PWM_AUDIO_CHECK(handle->ringbuf != NULL, PWM_AUDIO_ALLOC_ERROR, ESP_ERR_NO_MEM);

    handle->config = *cfg;
    g_pwm_audio_handle = handle;
#if (1==ISR_DEBUG)
    gpio_config_t io_conf;
    //disable interrupt
    io_conf.intr_type = GPIO_PIN_INTR_DISABLE;
    //set as output mode
    io_conf.mode = GPIO_MODE_OUTPUT;
    //bit mask of the pins that you want to set,e.g.GPIO18/19
    io_conf.pin_bit_mask = ISR_DEBUG_IO_MASK;
    //disable pull-down mode
    io_conf.pull_down_en = 0;
    //disable pull-up mode
    io_conf.pull_up_en = 0;
    //configure GPIO with the given settings
    gpio_config(&io_conf);
#endif

    /**
     * config ledc to generate pwm
     */
    handle->channel_mask = 0;
    handle->ledc_channel[CHANNEL_LEFT_INDEX].gpio_num = -1;

    if (handle->config.gpio_num_left >= 0) {
        handle->ledc_channel[CHANNEL_LEFT_INDEX].channel = handle->config.ledc_channel_left;
        handle->ledc_channel[CHANNEL_LEFT_INDEX].duty = 0; /**< duty=0 → pin LOW → N-MOS off → transistor off → no current through speaker (silent + power saving) */
        handle->ledc_channel[CHANNEL_LEFT_INDEX].gpio_num = handle->config.gpio_num_left;
        handle->ledc_channel[CHANNEL_LEFT_INDEX].speed_mode = LEDC_LOW_SPEED_MODE;
        handle->ledc_channel[CHANNEL_LEFT_INDEX].hpoint = 0;
        handle->ledc_channel[CHANNEL_LEFT_INDEX].timer_sel = handle->config.ledc_timer_sel;
        handle->ledc_channel[CHANNEL_LEFT_INDEX].flags.output_invert = 0; /**< no invert: low-side N-MOS circuit, LOW=off is the correct idle state */
        handle->ledc_channel[CHANNEL_LEFT_INDEX].intr_type = LEDC_INTR_DISABLE;
        res = ledc_channel_config(&handle->ledc_channel[CHANNEL_LEFT_INDEX]);
        PWM_AUDIO_CHECK(ESP_OK == res, "LEDC channel left configuration failed", ESP_ERR_INVALID_ARG);
        handle->channel_mask |= CHANNEL_LEFT_MASK;
    }

    PWM_AUDIO_CHECK(0 != handle->channel_mask, "Assign at least one channel gpio", ESP_ERR_INVALID_ARG);

    handle->ledc_timer.speed_mode = LEDC_LOW_SPEED_MODE;
    handle->ledc_timer.duty_resolution = handle->config.duty_resolution;
    //handle->ledc_timer.duty_resolution = 8;
    handle->ledc_timer.clk_cfg = LEDC_USE_APB_CLK;
    handle->ledc_timer.timer_num = handle->config.ledc_timer_sel;
    pwm_audio_reset_freq();
    res = ledc_timer_config(&handle->ledc_timer);
    PWM_AUDIO_CHECK(res == ESP_OK, "LEDC timer configuration failed", ESP_ERR_INVALID_ARG);

    /**
     * Get the address of LEDC register to reduce the addressing time
     */
    g_ledc_left_duty_val = &LEDC.channel_group[handle->ledc_timer.speed_mode].\
                           channel[handle->ledc_channel[CHANNEL_LEFT_INDEX].channel].duty.val;
    g_ledc_left_conf0_val = &LEDC.channel_group[handle->ledc_timer.speed_mode].\
                            channel[handle->ledc_channel[CHANNEL_LEFT_INDEX].channel].conf0.val;
    g_ledc_left_conf1_val = &LEDC.channel_group[handle->ledc_timer.speed_mode].\
                            channel[handle->ledc_channel[CHANNEL_LEFT_INDEX].channel].conf1.val;

    gptimer_config_t timer_config = {
        .clk_src = GPTIMER_CLK_SRC_DEFAULT,
        .direction = GPTIMER_COUNT_UP,
        .resolution_hz = TIMER_BASE_CLK / TIMER_DIVIDER,
    };

    gptimer_event_callbacks_t cbs = {
        .on_alarm = timer_group_isr,
    };

    res = gptimer_new_timer(&timer_config, &g_gptimer);
    PWM_AUDIO_CHECK(ESP_OK == res, "gptimer configuration failed", res);
    res = gptimer_register_event_callbacks(g_gptimer, &cbs, NULL);
    PWM_AUDIO_CHECK(ESP_OK == res, "gptimer register event callback failed", res);

    /**< set a initial parameter */
    res = pwm_audio_set_param(16000, 8, 1);
    PWM_AUDIO_CHECK(ESP_OK == res, "Set parameter failed", ESP_FAIL);

    pwm_audio_set_volume(0);

    handle->status = PWM_AUDIO_STATUS_IDLE;

    return ESP_OK;
}

esp_err_t pwm_audio_set_param(int rate, ledc_timer_bit_t bits, int ch)
{
    esp_err_t res = ESP_OK;

    /* Allow reconfiguration while BUSY: flush the ringbuf so the ISR doesn't
     * read stale data formatted for the old bits_per_sample.  The ISR itself
     * only uses duty_resolution (unchanged here), so there is no ISR-safety issue. */
    if (g_pwm_audio_handle->status == PWM_AUDIO_STATUS_BUSY) {
        rb_flush(g_pwm_audio_handle->ringbuf);
    }
    PWM_AUDIO_CHECK(rate <= SAMPLE_RATE_MAX && rate >= SAMPLE_RATE_MIN, PWM_AUDIO_FRAMERATE_ERROR, ESP_ERR_INVALID_ARG);
    PWM_AUDIO_CHECK(bits == 32 || bits == 16 || bits == 8, " Unsupported Bit width, only support 8, 16, 32", ESP_ERR_INVALID_ARG);
    PWM_AUDIO_CHECK(ch == 1, "Unsupported channel number, only support mono for NuttyBadge", ESP_ERR_INVALID_ARG);

    pwm_audio_data_t *handle = g_pwm_audio_handle;

    handle->framerate = rate;
    handle->bits_per_sample = bits;
    handle->channel_set_num = ch;

    gptimer_set_raw_count(g_gptimer, 0x00000000ULL);
    /* Configure the alarm value and the interrupt on alarm. */
    gptimer_alarm_config_t alarm_config = {
        .reload_count = 0,
        .alarm_count = (TIMER_BASE_CLK / TIMER_DIVIDER) / handle->framerate,
        .flags.auto_reload_on_alarm = true, // enable auto-reload
    };

    res = gptimer_set_alarm_action(g_gptimer, &alarm_config);
    PWM_AUDIO_CHECK(ESP_OK == res, "pwm_audio set param failed", res);
    return ESP_OK;
}

esp_err_t pwm_audio_set_sample_rate(int rate)
{
    esp_err_t res;
    PWM_AUDIO_CHECK(NULL != g_pwm_audio_handle, PWM_AUDIO_NOT_INITIALIZED, ESP_ERR_INVALID_STATE);
    PWM_AUDIO_CHECK(g_pwm_audio_handle->status != PWM_AUDIO_STATUS_BUSY, PWM_AUDIO_STATUS_ERROR, ESP_ERR_INVALID_ARG);
    PWM_AUDIO_CHECK(rate <= SAMPLE_RATE_MAX && rate >= SAMPLE_RATE_MIN, PWM_AUDIO_FRAMERATE_ERROR, ESP_ERR_INVALID_ARG);

    pwm_audio_data_t *handle = g_pwm_audio_handle;
    handle->framerate = rate;
    gptimer_alarm_config_t alarm_config = {
        .reload_count = 0,
        .alarm_count = (TIMER_BASE_CLK / TIMER_DIVIDER) / handle->framerate,
        .flags.auto_reload_on_alarm = true, // enable auto-reload
    };
    res = gptimer_set_alarm_action(g_gptimer, &alarm_config);
    PWM_AUDIO_CHECK(ESP_OK == res, "pwm_audio set sample rate failed", res);
    return ESP_OK;
}

esp_err_t pwm_audio_set_volume(int8_t volume)
{
    pwm_audio_data_t *handle = g_pwm_audio_handle;
    PWM_AUDIO_CHECK(NULL != handle, PWM_AUDIO_NOT_INITIALIZED, ESP_ERR_INVALID_STATE);
    if (volume < 0) {
        PWM_AUDIO_CHECK(-volume <= MAX_VOLUME, "Volume is too small", ESP_ERR_INVALID_ARG);
    } else {
        PWM_AUDIO_CHECK(volume <= MAX_VOLUME, "Volume is too large", ESP_ERR_INVALID_ARG);
    }

    handle->volume = volume;
    return ESP_OK;
}

esp_err_t pwm_audio_get_volume(int8_t *volume)
{
    pwm_audio_data_t *handle = g_pwm_audio_handle;
    PWM_AUDIO_CHECK(NULL != handle, PWM_AUDIO_NOT_INITIALIZED, ESP_ERR_INVALID_STATE);
    PWM_AUDIO_CHECK(NULL != volume, PWM_AUDIO_PARAM_ADDR_ERROR, ESP_ERR_INVALID_ARG);
    *volume = handle->volume;
    return ESP_OK;
}

esp_err_t IRAM_ATTR pwm_audio_write(uint8_t *inbuf, size_t inbuf_len, size_t *bytes_written, TickType_t ticks_to_wait)
{
    esp_err_t res = ESP_OK;
    pwm_audio_data_t *handle = g_pwm_audio_handle;
    PWM_AUDIO_CHECK(NULL != handle, PWM_AUDIO_NOT_INITIALIZED, ESP_ERR_INVALID_STATE);
    PWM_AUDIO_CHECK(inbuf != NULL && bytes_written != NULL, "Invalid pointer", ESP_ERR_INVALID_ARG);
    PWM_AUDIO_CHECK(inbuf_len != 0, "Length should not be zero", ESP_ERR_INVALID_ARG);

    *bytes_written = 0;
    ringbuf_handle_t *rb = handle->ringbuf;
    TickType_t start_ticks = xTaskGetTickCount();

    while (inbuf_len) {
        uint32_t free = rb_get_free(rb);
        if (ESP_OK == rb_wait_semaphore(rb, ticks_to_wait)) {
            uint32_t bytes_can_write = inbuf_len;

            if (inbuf_len > free) {
                bytes_can_write = free;
            }

            /**< For case 8 + duty_resolution > 8: each input byte expands to 2 ringbuf bytes.
             *   Cap to free/2 so the ringbuf cannot overflow (without this, the first write on
             *   an empty 8192-byte ringbuf tries to write 16376 bytes, silently dropping half). */
            if (handle->bits_per_sample == 8 && handle->config.duty_resolution > 8) {
                uint32_t expansion_cap = free >> 1;
                if (bytes_can_write > expansion_cap) {
                    bytes_can_write = expansion_cap;
                }
            }

            bytes_can_write &= 0xfffffffc;/**< Aligned data, bytes_can_write should be an integral multiple of 4 */

            if (0 == bytes_can_write) {
                if (inbuf_len < 4) {
                    *bytes_written += inbuf_len;  /**< Discard the final 1-3 misaligned tail bytes */
                    return ESP_OK;
                }
                /**< free < 4 but inbuf_len >= 4: ringbuf nearly full, not a tail-end condition.
                 *   Without this continue, bytes_can_write=0 causes the entire remaining buffer
                 *   (potentially hundreds of KB) to be discarded and falsely counted as written —
                 *   the root cause of the "Written=N; Left=0 but no audio" race condition.
                 *   Wait for the ISR to drain enough space before retrying. */
                continue;
            }

            /**< Get the difference between PWM resolution and audio samplewidth */
            int8_t shift = handle->bits_per_sample - handle->config.duty_resolution;
            uint32_t len = bytes_can_write;

            switch (handle->bits_per_sample) {
            case 8: {
                if (handle->config.duty_resolution > 8) {
                    /**< Upscale 8-bit [0,255] to duty_resolution bits by left-shifting,
                     *   then write 2-byte little-endian so ISR reads it like case 16.
                     *   e.g. 10-bit: 128 (silence) → 128<<2=512 (exact 10-bit midpoint). */
                    const int upshift = handle->config.duty_resolution - 8;
                    for (size_t i = 0; i < len; i++) {
                        int32_t s = (int32_t)inbuf[i] - 128;
                        s = (s * handle->volume) / 32;
                        s += 128;
                        if (s < 0)   s = 0;
                        if (s > 255) s = 255;
                        uint16_t duty = (uint16_t)(uint8_t)s << upshift;
                        rb_write_byte(rb, (uint8_t)duty);
                        rb_write_byte(rb, (uint8_t)(duty >> 8));
                    }
                } else {
                    for (size_t i = 0; i < len; i++) {
                        int32_t s = (int32_t)inbuf[i] - 128;
                        s = (s * handle->volume) / 32;
                        s += 128;
                        if (s < 0)   s = 0;
                        if (s > 255) s = 255;
                        rb_write_byte(rb, (uint8_t)s);
                    }
                }
            }
            break;

            case 16: {
                len >>= 1;
                uint16_t *buf_16b = (uint16_t *)inbuf;
                uint16_t value_16b;
                int16_t temp;

                if (handle->config.duty_resolution > 8) {
                    for (size_t i = 0; i < len; i++) {
                        temp = buf_16b[i];
                        temp = temp * handle->volume / 32;
                        value_16b = (uint16_t)(temp + 0x8000); /**< offset: maps -32768→0, 0→32768, 32767→65535 */
                        value_16b >>= shift;
                        rb_write_byte(rb, value_16b);
                        rb_write_byte(rb, value_16b >> 8);
                    }
                } else {
                    /**
                     * When the PWM resolution is 8 bit, only one byte is transmitted
                     */
                    for (size_t i = 0; i < len; i++) {
                        temp = buf_16b[i];
                        temp = temp * handle->volume / 32;
                        value_16b = (uint16_t)(temp + 0x8000); /**< offset */
                        value_16b >>= shift;
                        rb_write_byte(rb, value_16b);
                    }
                }
            }
            break;

            case 32: {
                len >>= 2;
                uint32_t *buf_32b = (uint32_t *)inbuf;
                uint32_t value;
                int32_t temp;

                if (handle->config.duty_resolution > 8) {
                    for (size_t i = 0; i < len; i++) {
                        temp = buf_32b[i];
                        temp = temp * handle->volume / 32;
                        value = (uint32_t)temp + 0x80000000u; /**< offset: maps INT32_MIN→0, 0→0x80000000, INT32_MAX→0xFFFFFFFF */
                        value >>= shift;
                        rb_write_byte(rb, value);
                        rb_write_byte(rb, value >> 8);
                    }
                } else {
                    /**
                     * When the PWM resolution is 8 bit, only one byte is transmitted
                     */
                    for (size_t i = 0; i < len; i++) {
                        temp = buf_32b[i];
                        temp = temp * handle->volume / 32;
                        value = (uint32_t)temp + 0x80000000u; /**< offset */
                        value >>= shift;
                        rb_write_byte(rb, value);
                    }
                }
            }
            break;

            default:
                break;
            }

            inbuf += bytes_can_write;
            inbuf_len -= bytes_can_write;
            *bytes_written += bytes_can_write;

        } else {
            res = ESP_FAIL;
        }

        if ((xTaskGetTickCount() - start_ticks) >= ticks_to_wait) {
            return res;
        }
    }

    return res;
}

esp_err_t pwm_audio_start(void)
{
    esp_err_t res;
    pwm_audio_data_t *handle = g_pwm_audio_handle;
    PWM_AUDIO_CHECK(NULL != handle, PWM_AUDIO_NOT_INITIALIZED, ESP_ERR_INVALID_STATE);
    PWM_AUDIO_CHECK(handle->status == PWM_AUDIO_STATUS_IDLE, PWM_AUDIO_STATUS_ERROR, ESP_ERR_INVALID_STATE);
    handle->status = PWM_AUDIO_STATUS_BUSY;

    res = gptimer_enable(g_gptimer);
    PWM_AUDIO_CHECK(res == ESP_OK, "gptimer enable fail", res);
    res = gptimer_start(g_gptimer);
    PWM_AUDIO_CHECK(res == ESP_OK, "gptimer start fail", res);
    return ESP_OK;
}

esp_err_t pwm_audio_stop(void)
{
    esp_err_t res;
    pwm_audio_data_t *handle = g_pwm_audio_handle;
    PWM_AUDIO_CHECK(NULL != handle, PWM_AUDIO_NOT_INITIALIZED, ESP_ERR_INVALID_STATE);
    PWM_AUDIO_CHECK(handle->status == PWM_AUDIO_STATUS_BUSY, PWM_AUDIO_STATUS_ERROR, ESP_ERR_INVALID_STATE);

    /**< just disable timer ,keep pwm output to reduce switching nosie */
    /**< timer disable interrupt */
    res = gptimer_stop(g_gptimer);
    PWM_AUDIO_CHECK(res == ESP_OK, "gptimer stop failed", res);
    res = gptimer_disable(g_gptimer);
    PWM_AUDIO_CHECK(res == ESP_OK, "gptimer disable failed", res);
    rb_flush(handle->ringbuf);  /**< flush ringbuf, avoid play noise */

    /**< duty=0 → pin LOW → N-MOS off; avoids holding the last sample duty after stop */
    ledc_set_duty(handle->ledc_channel[CHANNEL_LEFT_INDEX].speed_mode,
                  handle->ledc_channel[CHANNEL_LEFT_INDEX].channel, 0);
    ledc_update_duty(handle->ledc_channel[CHANNEL_LEFT_INDEX].speed_mode,
                     handle->ledc_channel[CHANNEL_LEFT_INDEX].channel);

    handle->status = PWM_AUDIO_STATUS_IDLE;
    return ESP_OK;
}

esp_err_t pwm_audio_deinit(void)
{
    esp_err_t res;
    pwm_audio_data_t *handle = g_pwm_audio_handle;
    PWM_AUDIO_CHECK(handle != NULL, PWM_AUDIO_PARAM_ADDR_ERROR, ESP_FAIL);
    handle->status = PWM_AUDIO_STATUS_UN_INIT;

    res = gptimer_del_timer(g_gptimer);
    PWM_AUDIO_CHECK(res == ESP_OK, "gptimer del failed", res);

    for (size_t i = 0; i < PWM_AUDIO_CH_MAX; i++) {
        if (handle->ledc_channel[i].gpio_num >= 0) {
            /**< idle_level=0, no invert → pin is driven LOW (0 V) → N-MOS off = silent + power saving */
            ledc_stop(handle->ledc_channel[i].speed_mode, handle->ledc_channel[i].channel, 0);
        }
    }

    /**< drive pins LOW explicitly; GPIO_MODE_INPUT leaves the line floating and picks up noise */
    for (size_t i = 0; i < PWM_AUDIO_CH_MAX; i++) {
        if (handle->ledc_channel[i].gpio_num >= 0) {
            gpio_set_direction(handle->ledc_channel[i].gpio_num, GPIO_MODE_OUTPUT);
            gpio_set_level(handle->ledc_channel[i].gpio_num, 0);
        }
    }

    rb_destroy(handle->ringbuf);
    heap_caps_free(handle);
    g_pwm_audio_handle = NULL;
    return ESP_OK;
}
