NuttyShell/NuttyBadge/(commit log)

2024-05-04 NuttyOS Basic
    [partitions.csv]
2024-05-10 Driver dev + sdkconfig
2024-05-19 Added NuttyApps, Finished Menu, Added lcd driver comments, Integrated LVGL Indev with NuttyInput, added NuttyInput USB UART Input to control the screen for debugging purposes
2024-05-20 Fixed IOE Declaration; Added SystemTrayArea; Added System Info on System Tray Area; Use custom small font for System Tray Area; TODO: 5V Detection is fucked up
    [NuttySystemMonitor.c, NuttySystemMonitor.h, config.h]
2024-05-27 Now NuttyStorage auto mounts FAT32
2024-05-27 Fixed audio first buffer not playing issue, different volume for NuttyTest now
    [NuttyAudio.c]
2024-05-27 change loop max frequency
    change loop max frequency to 1000HZ so pdMS_TO_TICKS(1) is possible
2024-05-28 Apps TODO, NuttyAudio bug fixes, NuttyInput increase poll rate, NuttyStorage use CD
    [NuttyAudio.c, NuttyAudioPlayer.c, NuttyAudioPlayer.h]
2024-05-29 FileManager can selected files and support paramed input now, TODO: Back button; Added NuttyShowImage; NuttyRemote add back TODO labels
2024-06-05 Initial Commit, NuttyHardware are final. NuttyOS files will be updated soon.
    [BOM_PCBA.xlsx, BOM_PCBA_整合BOM.xlsx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]
2025-06-06 chore(nuttyos-merge): move everything in NuttyOS repo to NuttyOS directory
    [partitions.csv]
2025-06-06 chore(nuttyos-merge): remove old NuttyOS files
    [partitions.csv]
2026-05-27 fix: return esp_err_t instead of void for set_pixel_rgb
    [rgb.c]
2026-05-27 I2C and RMT updates
2026-05-28 Fixed IDF version, prepare to bump to v5.5.4 for sdkconfig
    [NuttyPeripherals.h, config.h, main.c]
2026-05-28 [NUTTYBADGE-REVC] Bump: ESP-IDF v6.0.1, fixed IDF v5 code affecting SD/RMT/PWM_AUDIO, added OLED Display Driver
    [NuttyPeripherals.c, NuttyPeripherals.h, ir.c, ir.h, lcd.c, pwm_audio.h, sdcard.c]
2026-05-30 fix: update NUTTYBADGE_REVC_OLED definition to 0
    [config.h]
2026-05-30 fix: update NUTTYBADGE_REVC_OLED definition to be commented out
    [config.h]
2026-05-30 feat: add 'Crazy' action to audio player with LED effects
2026-05-30 feat: enhance beat-flash effect and optimize LED control in audio player
2026-05-30 feat: update LED control to sync brightness with audio amplitude
2026-05-30 [HARDWARE] NuttyBadge Revision B
    [BOM_PCBA.xlsx, BOM_PCBA_整合BOM.xlsx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]
2026-05-30 [HARDWARE] Rename old revision to *_reva
    [BOM_PCBA.xlsx, BOM_PCBA_整合BOM.xlsx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]
2026-05-30 [HARDWARE] NuttyBadge Rev. C (May-2026)
    [BOM_PCBA.xlsx, BOM_PCBA_整合BOM.xlsx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]
2026-05-31 feat: fix volume adjustment direction for audio player actions
    [NuttyAudioPlayer.c]
2026-05-31 BUGFIX: NuttyInput fixes to increase buttons response time
2026-06-01 [BUGFIX] NuttyAudio WIP: Fix audio quality
    [NuttyAudio.c, pwm_audio.c]
2026-06-03 FEAT: NuttyOS Power Saving
2026-06-03 FEAT: Enable Power Manager by default
2026-06-03 FIXED: Audio static noise due to incorrect invert value (NMOS is low-side switching, no inversion required); Prevent CPU congestion on pwmAudioStatus
    [NuttyAudio.c, pwm_audio.c]
2026-06-03 BUGFIX: pwm_audio return prematurely
    [NuttyAudio.c, pwm_audio.c]
2026-06-03 FEAT: Audio is now 10-bits, increased pwm_audio ringbuf size, increased volume, verified 8/16 bits src audio playback
2026-06-04 NuttyTest: No BL test for OLED (Rev. C); NuttyInput Service: Add UART ctrl for SELECT btn
2026-06-04 bug fixes, fixed UI, added level design
    [main.c]
2026-06-04 fix: move NuttyDOOM position in the menu
    [main.c]
2026-06-04 Revert "😈 NuttyDOOM"
